leoperezlievano/SDR_UN/HW/shield_SDR_UN/Foto.jpeg

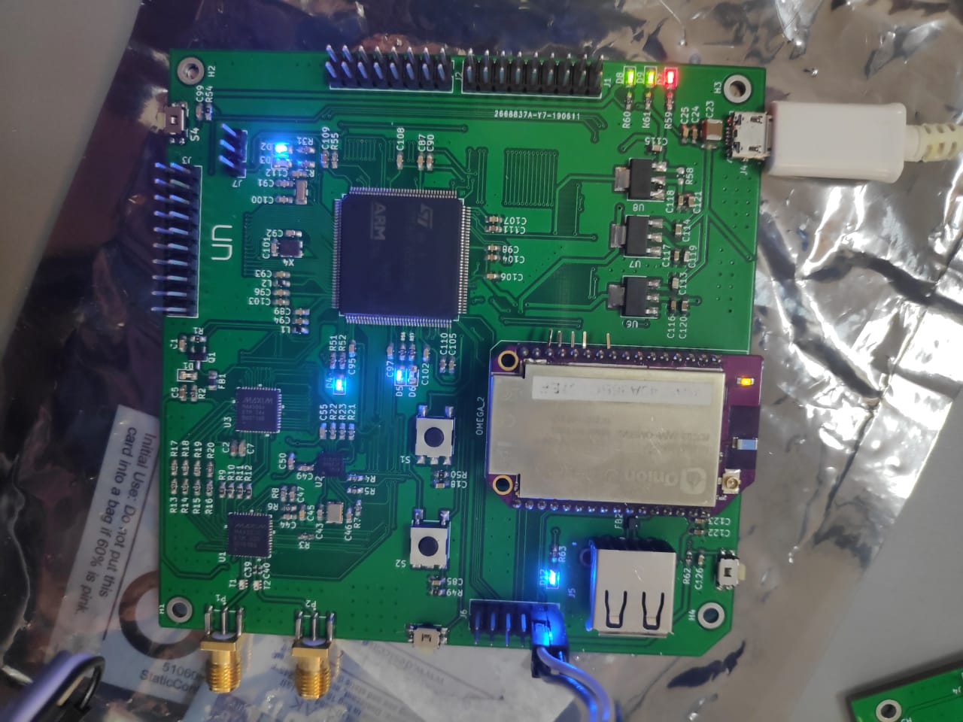
HW/shield_SDR_UN/Foto.jpeg
