leoperezlievano/SDR_UN/Imagenes GITHUB/bot.png

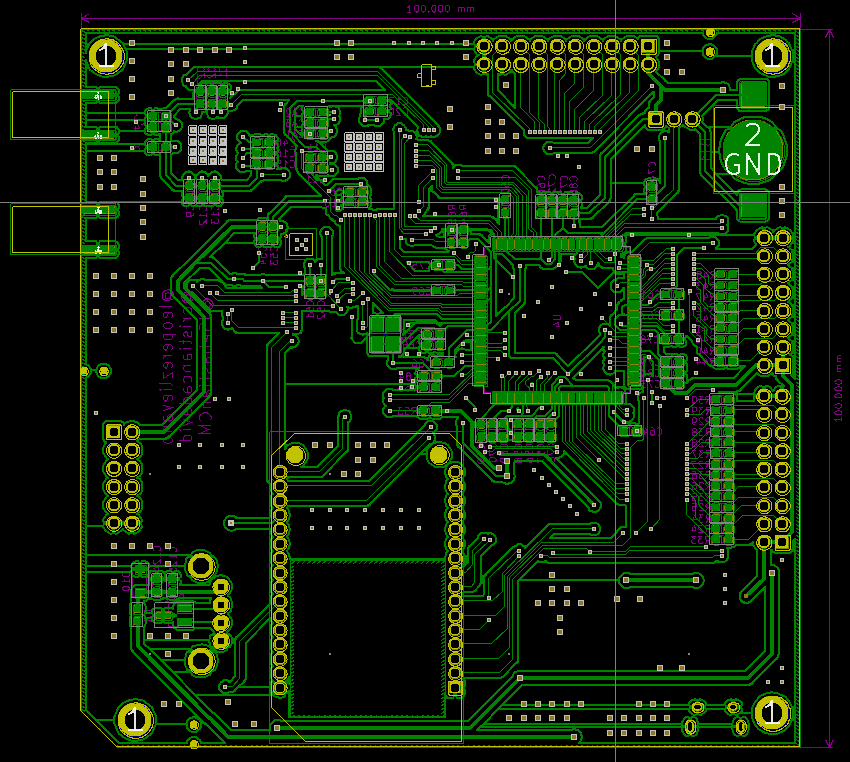
Imagenes GITHUB/bot.png
