leoperezlievano/SDR_UN/Imagenes GITHUB/bot_3d.png

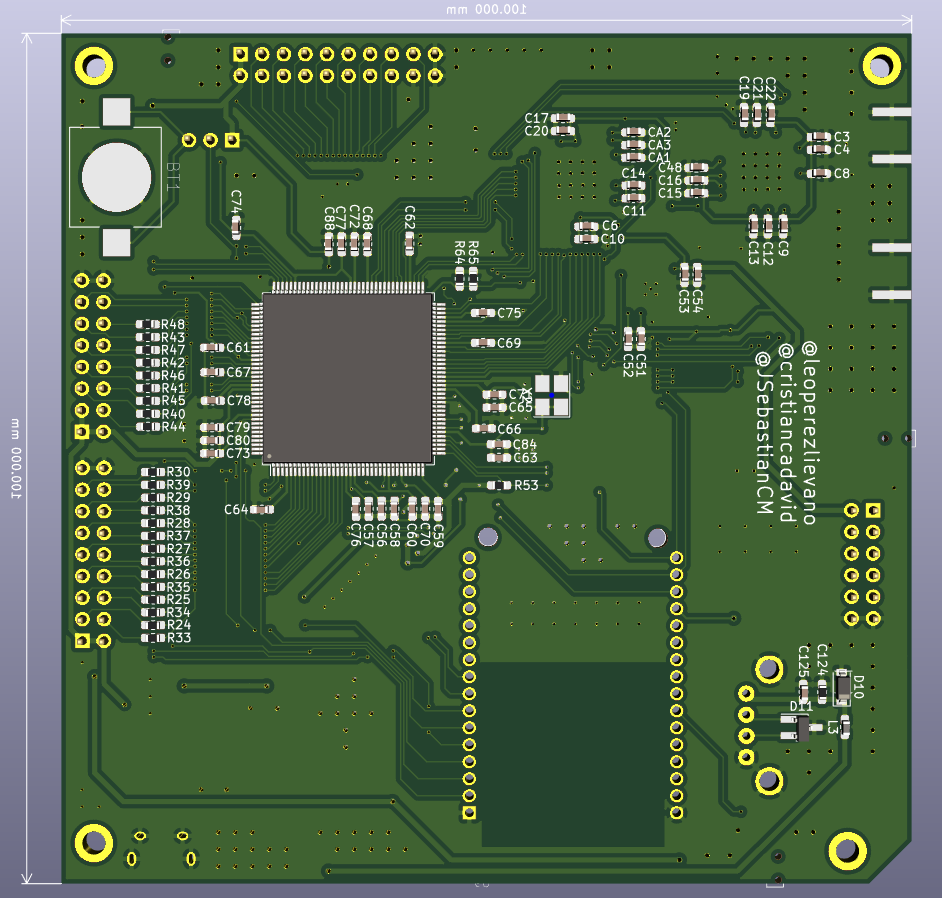
Imagenes GITHUB/bot_3d.png
