leoperezlievano/SDR_UN/Imagenes GITHUB/Esquemático_KiCAD.png

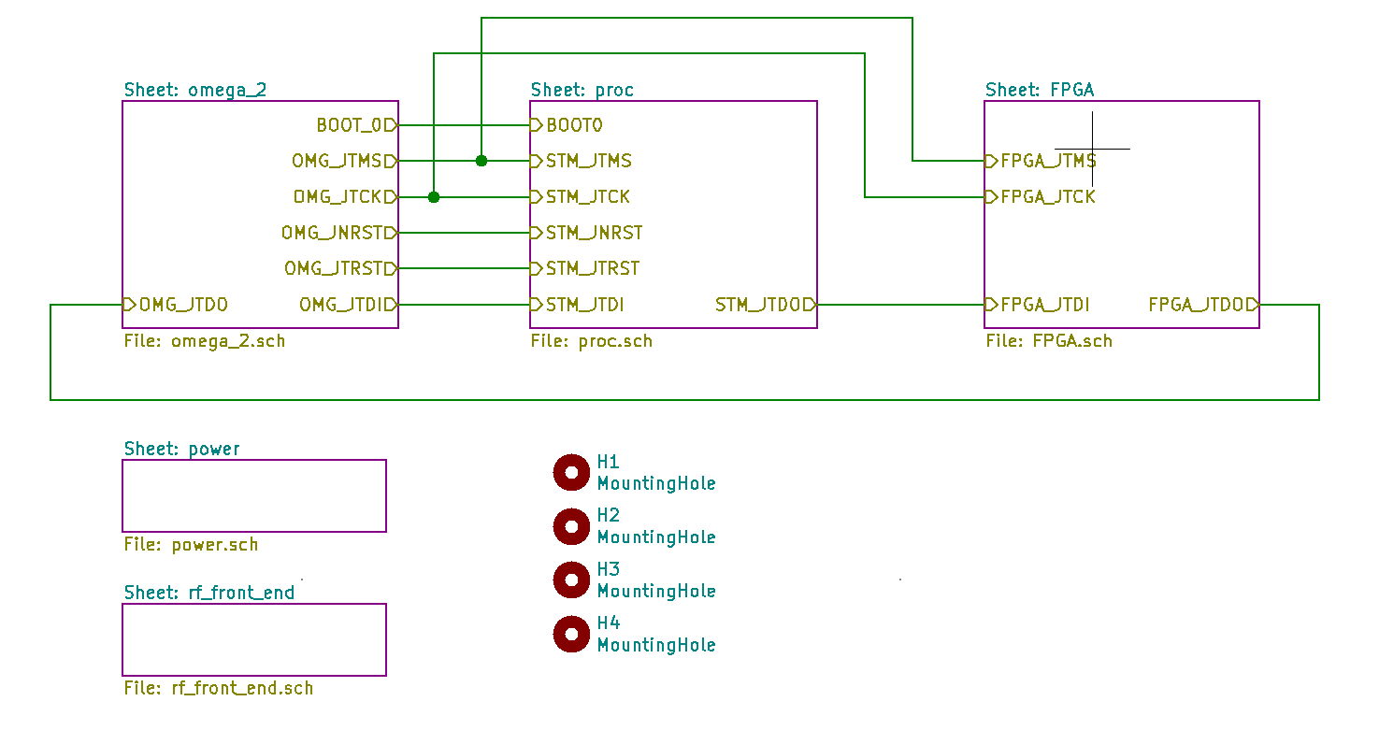
Imagenes GITHUB/Esquemático_KiCAD.png
