leoperezlievano/SDR_UN/Imagenes GITHUB/openocd_1.png

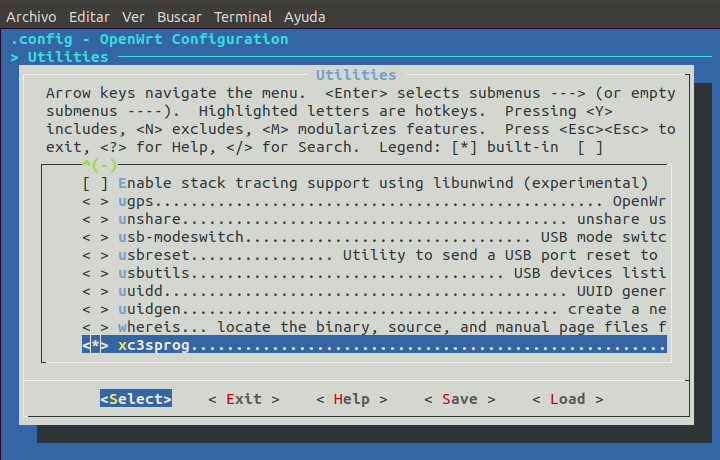
Imagenes GITHUB/openocd_1.png
