leoperezlievano/SDR_UN/Imagenes GITHUB/Roteo.png

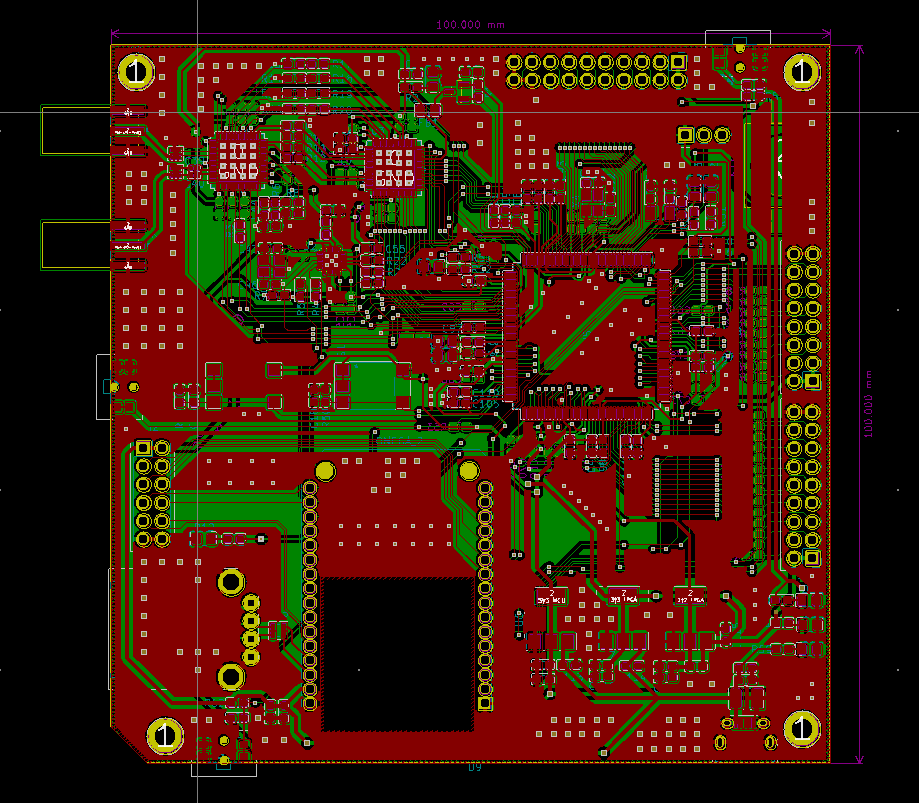
Imagenes GITHUB/Roteo.png
