leoperezlievano/SDR_UN/Imagenes GITHUB/top.png

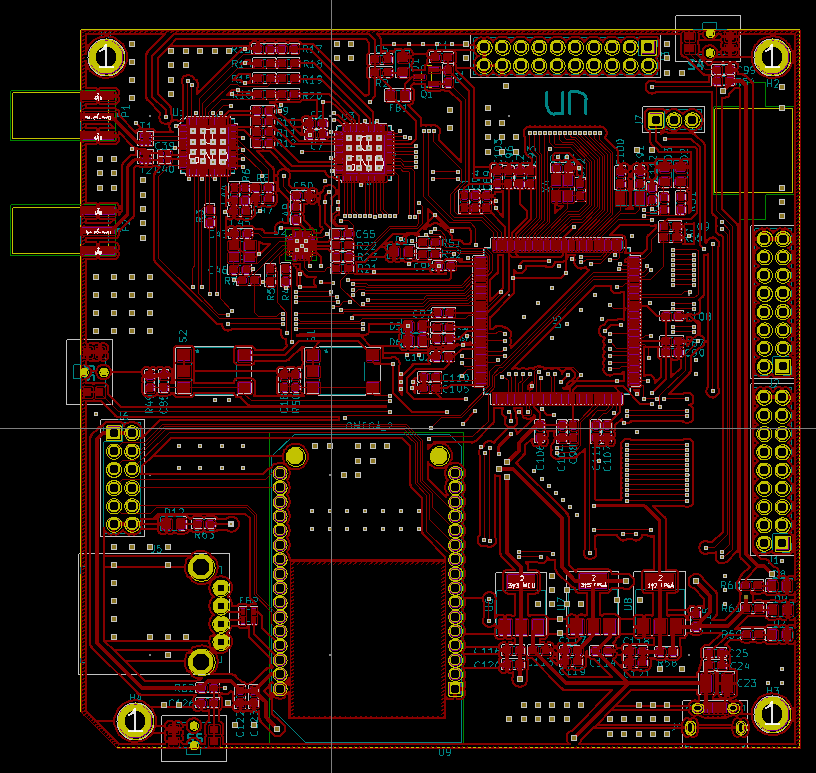
Imagenes GITHUB/top.png
