leoperezlievano/SDR_UN/Imagenes GITHUB/top_3d.png

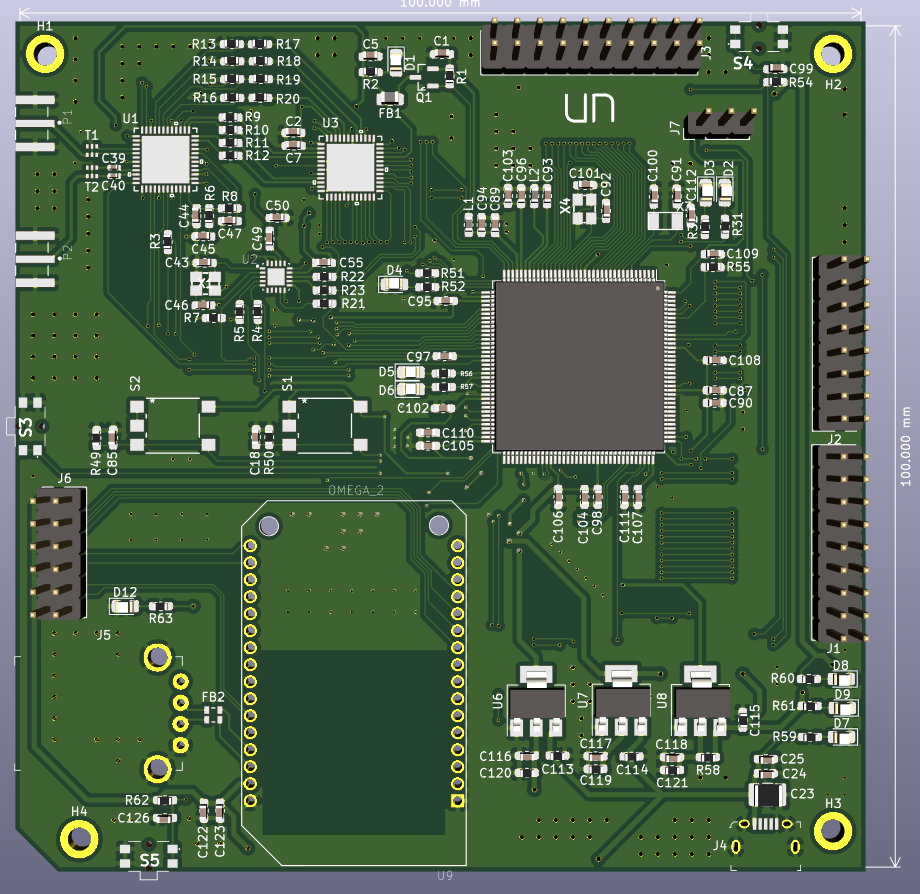
Imagenes GITHUB/top_3d.png
