leoperezlievano/SDR_UN/Imagenes GITHUB/xc3sprog_openocd.png

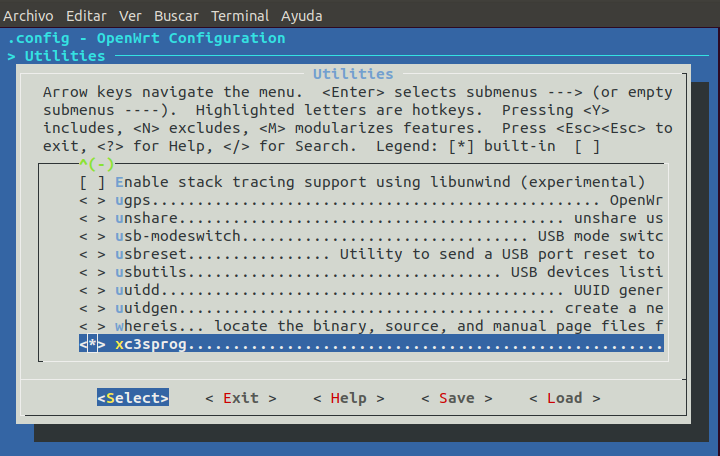
Imagenes GITHUB/xc3sprog_openocd.png
