leoperezlievano/SDR_UN/HW/partes_final.ods

Referencia | Valor | Digikey | Qty (final) | Unit price | Total price
BT1 | Battery_Cell | BK-870-ND | 1 | $0,54 | $0,54
> C3, C8, C9, C12, C22, C44 | 100pF | 1276-1909-1-ND | 10 | $0,04 | $0,42
> C4, C5 | 10uF | 1276-1192-1-ND | 4 | $0,20 | $0,79
> C2, C6, C11, C17, C110, C111 | 2.2uF | 1276-1085-1-ND | 10 | $0,08 | $0,83
> C1, C7, C10, C14, C18, C20, C24, C48, C51-C55, C84, C85, C87-C89, C93, C95-C99, C102, C105-C108, C112, C116-C118, C123, C125, C126 | 100nF | 1276-1000-1-ND | 50 | $0,01 | $0,62
> C13, C15, C16, C19, C21 | 10nF | 1276-1009-1-ND | 10 | $0,04 | $0,39
C23 | 220uF | 1276-3375-1-ND | 2 | $1,68 | $3,36
C25 | 1nF | 1276-1018-1-ND | 2 | $0,10 | $0,20
> C39, C40 | 0 | 311-0.0JRCT-ND | 5 | $0,02 | $0,08
> C43, C46 | 1.8pF | 1276-2218-1-ND | 5 | $0,05 | $0,24
C45 | 2.2nF | 1276-1987-1-ND | 2 | $0,10 | $0,20
C47 | 68pF | 1276-6538-1-ND | 2 | $0,10 | $0,20
C49 | 33pF | 1276-1070-1-ND | 2 | $0,10 | $0,20
C50 | 47pF | 1276-1037-1-ND | 2 | $0,10 | $0,20
> C56-C66, C71, C72, C77, C79, C109 | 4.7uF | 1276-1045-1-ND | 20 | $0,04 | $0,78
> C67-C70, C73-C76, C78, C80 | 0.47uF | 1276-2082-1-ND | 15 | $0,07 | $1,10
> C91, C100 | 6pF | 1276-2133-1-ND | 5 | $0,04 | $0,21
> C92, C101 | 10pF | 1276-1027-1-ND | 5 | $0,04 | $0,20
> C90, C94, C103, C104, C122 | 1uF | 1276-1182-1-ND | 10 | $0,04 | $0,38
> C113-C115, C119-C121, C124 | 22uF | 1276-6504-1-ND | 10 | $0,24 | $2,38
> CA1-CA3 | 330nF | 1276-2048-1-ND | 5 | $0,09 | $0,46
> D1, D8, D9 | LED_GREEN | 160-1468-1-ND | 5 | $0,29 | $1,45
> D2-D6, D12 | LED_BLUE | 160-2032-1-ND | 10 | $0,36 | $3,60
D7 | LED_RED | 160-1469-1-ND | 2 | $0,31 | $0,62
D10 | D_Zener-5.1V-1W | MMSZ5231BT1GOSCT-ND | 2 | $0,23 | $0,46
D11 | SP0502BAHT | F2714CT-ND | 2 | $0,73 | $1,46
FB1 | FILTER | 490-1054-1-ND | 2 | $0,10 | $0,20
FB2 | SRF2012-900YA | SRF2012-900YACT-ND | 1 | $0,36 | $0,36
J1 | Conn_02x09_Odd_Even | 609-6336-ND | 1 | $0,89 | $0,89
J2 | Conn_02x08_Odd_Even | 609-6336-ND | 1 | $0,89 | $0,89
J3 | Conn_02x10_Top_Bottom | 609-3221-ND | 1 | $0,72 | $0,72
J4 | USB_B_Micro | 609-4618-1-ND | 2 | $0,42 | $0,84
J5 | USB_A | UE27AC54100-ND | 1 | $0,60 | $0,60
J6 | Conn_02x06_Odd_Even | 609-3219-ND | 1 | $0,44 | $0,44
J7 | Conn_01x03_Male | 732-5316-ND | 1 | $0,13 | $0,13
> L1, L2 | bead, 600R, 350 mA | 587-1897-1-ND | 2 | $0,10 | $0,20
L3 | L | 732-1593-1-ND | 2 | $0,17 | $0,34
> P1, P2 | GSG-RF-CONN | CON-SMA-EDGE-S-ND | 2 | $1,74 | $3,48
Q1 | MOSFET_P | DMP2305UDICT-ND | 2 | $0,51 | $1,02
> R1, R49, R50, R54, R62 | 10k | 311-10KGRCT-ND | 10 | $0,02 | $0,20
> R2, R31, R32, R51, R52, R56, R57, R60, R61, R63 | 470 | 311-470GRCT-ND | 15 | $0,02 | $0,30
> R4, R5, R7, R59 | 1.8k | 311-1.8KGRCT-ND | 10 | $0,02 | $0,20
R6 | 1.2k | 311-1.20KHRCT-ND | 2 | $0,10 | $0,20
R8 | 750 | 311-750HRCT-ND | 2 | $0,10 | $0,20
> R9-R12 | 0 | RMCF0603ZT0R00CT-ND | 10 | $0,02 | $0,16
> R13-R16, R53 | 4.7k | 311-4.70KHRCT-ND | 10 | $0,02 | $0,24
> R3, R17-R20, R55 | 1k | 311-1.00KHRCT-ND | 10 | $0,02 | $0,24
 | 39 | 311-39.0HRCT-ND | 10 | $0,02 | $0,24
> R24-R30, R33-R48 | 200 | 311-200GRCT-ND | 30 | $0,02 | $0,60
R58 | 100 | 311-100HRCT-ND | 2 | $0,10 | $0,20
> R64, R65 | 1.5k | 311-1.5KGRCT-ND | 4 | $0,10 | $0,40
> S1, S2 | FSM1LPTR | 450-1756-1-ND | 3 | $0,48 | $1,44
> S3-S5 | TL1014BF160QG | EG5042CT-ND | 5 | $0,81 | $4,05
> T1, T2 | BALUN | 445-172632-1-ND | 3 | $0,35 | $1,05
U1 | MAX2830 | MAX2830ETM+TCT-ND | 1 | $10,65 | $10,65
U2 | SI5351C | 336-5160-1-ND | 1 | $2,42 | $2,42
U3 | MAX5864 | MAX5864ETM+-ND | 1 | $11,21 | $11,21
U4 | XC6SLX9-2TQG144C | 122-1745-ND | 1 | $16,52 | $16,52
U5 | STM32F722ZET | 497-18558-ND | 1 | $10,74 | $10,74
> U6, U7 | ZLDO1117G33TA | ZLDO1117G33DICT-ND | 4 | $0,50 | $2,00
U8 | ZLDO1117G12TA | ZLDO1117G12DICT-ND | 3 | $0,50 | $1,50
X1 | GSG-XTAL4PIN-25MHz | 535-13468-1-ND | 1 | $0,74 | $0,74
X2 | ASE-xxxMHz | 535-11114-1-ND | 1 | $3,30 | $3,30
X3 | CRYSTAL | 644-1171-1-ND | 1 | $0,68 | $0,68
X4 | GSG-XTAL4PIN-16MHz | 535-10289-1-ND | 1 | $0,73 | $0,73
Extra Capacitors 1 | 3pF | 1276-1597-1-ND | 3 | $0,10 | $0,30
Extra Capacitors 2 | 22pF | 1276-6456-1-ND | 3 | $0,14 | $0,42
Terminal Strip Onion | Conn_01x16 | 1212-1317-ND | 1 | $3,32 | $3,32
SMA Extra | SMA | WM5536-ND | 1 | $3,64 | $3,64
 |  |  |  | TOTAL | $109,36 | USD
 |  |  |  | TRM | $3.288,00
 |  |  |  |  | $359.565,82 | COP
