leoperezlievano/SDR_UN/(threads)

Thread 1 (2019-07-24):

Wiki

cristiancadavid, 2019-07-24:
Bienvenidos
Bienvenido a su SDR_UN wiki, donde econtrará los pasos necesarios para diseñar y poner en funcionamiento una PCB que cuenta con un sistema embebido Onion-Omega2, un microcontrolador STM32F7422 y finalmente una FPGA x9
