leoperezlievano/SDR_UN/HW/shield_SDR_UN/shield_SDR_UN.pdf

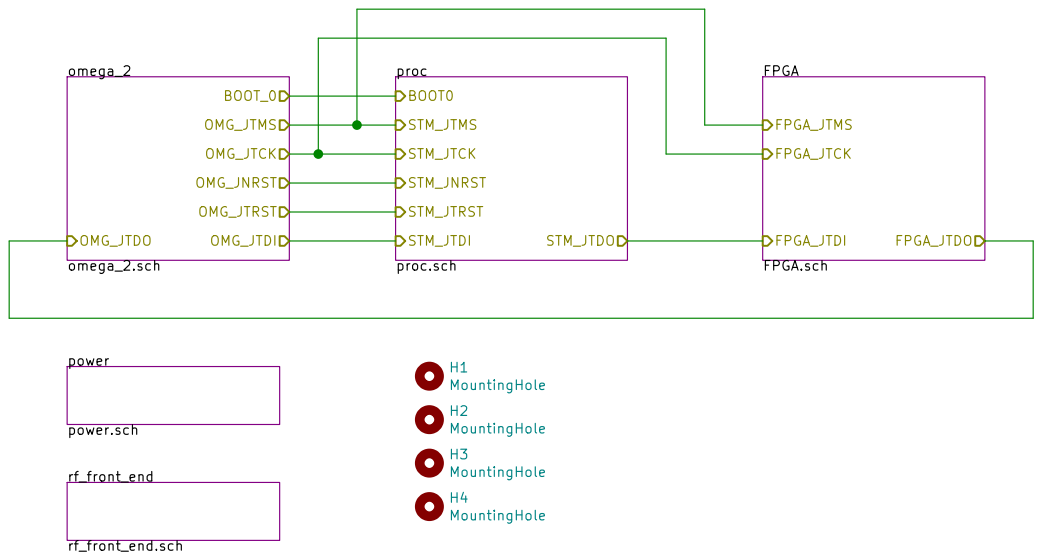
[picture p10: page 1]

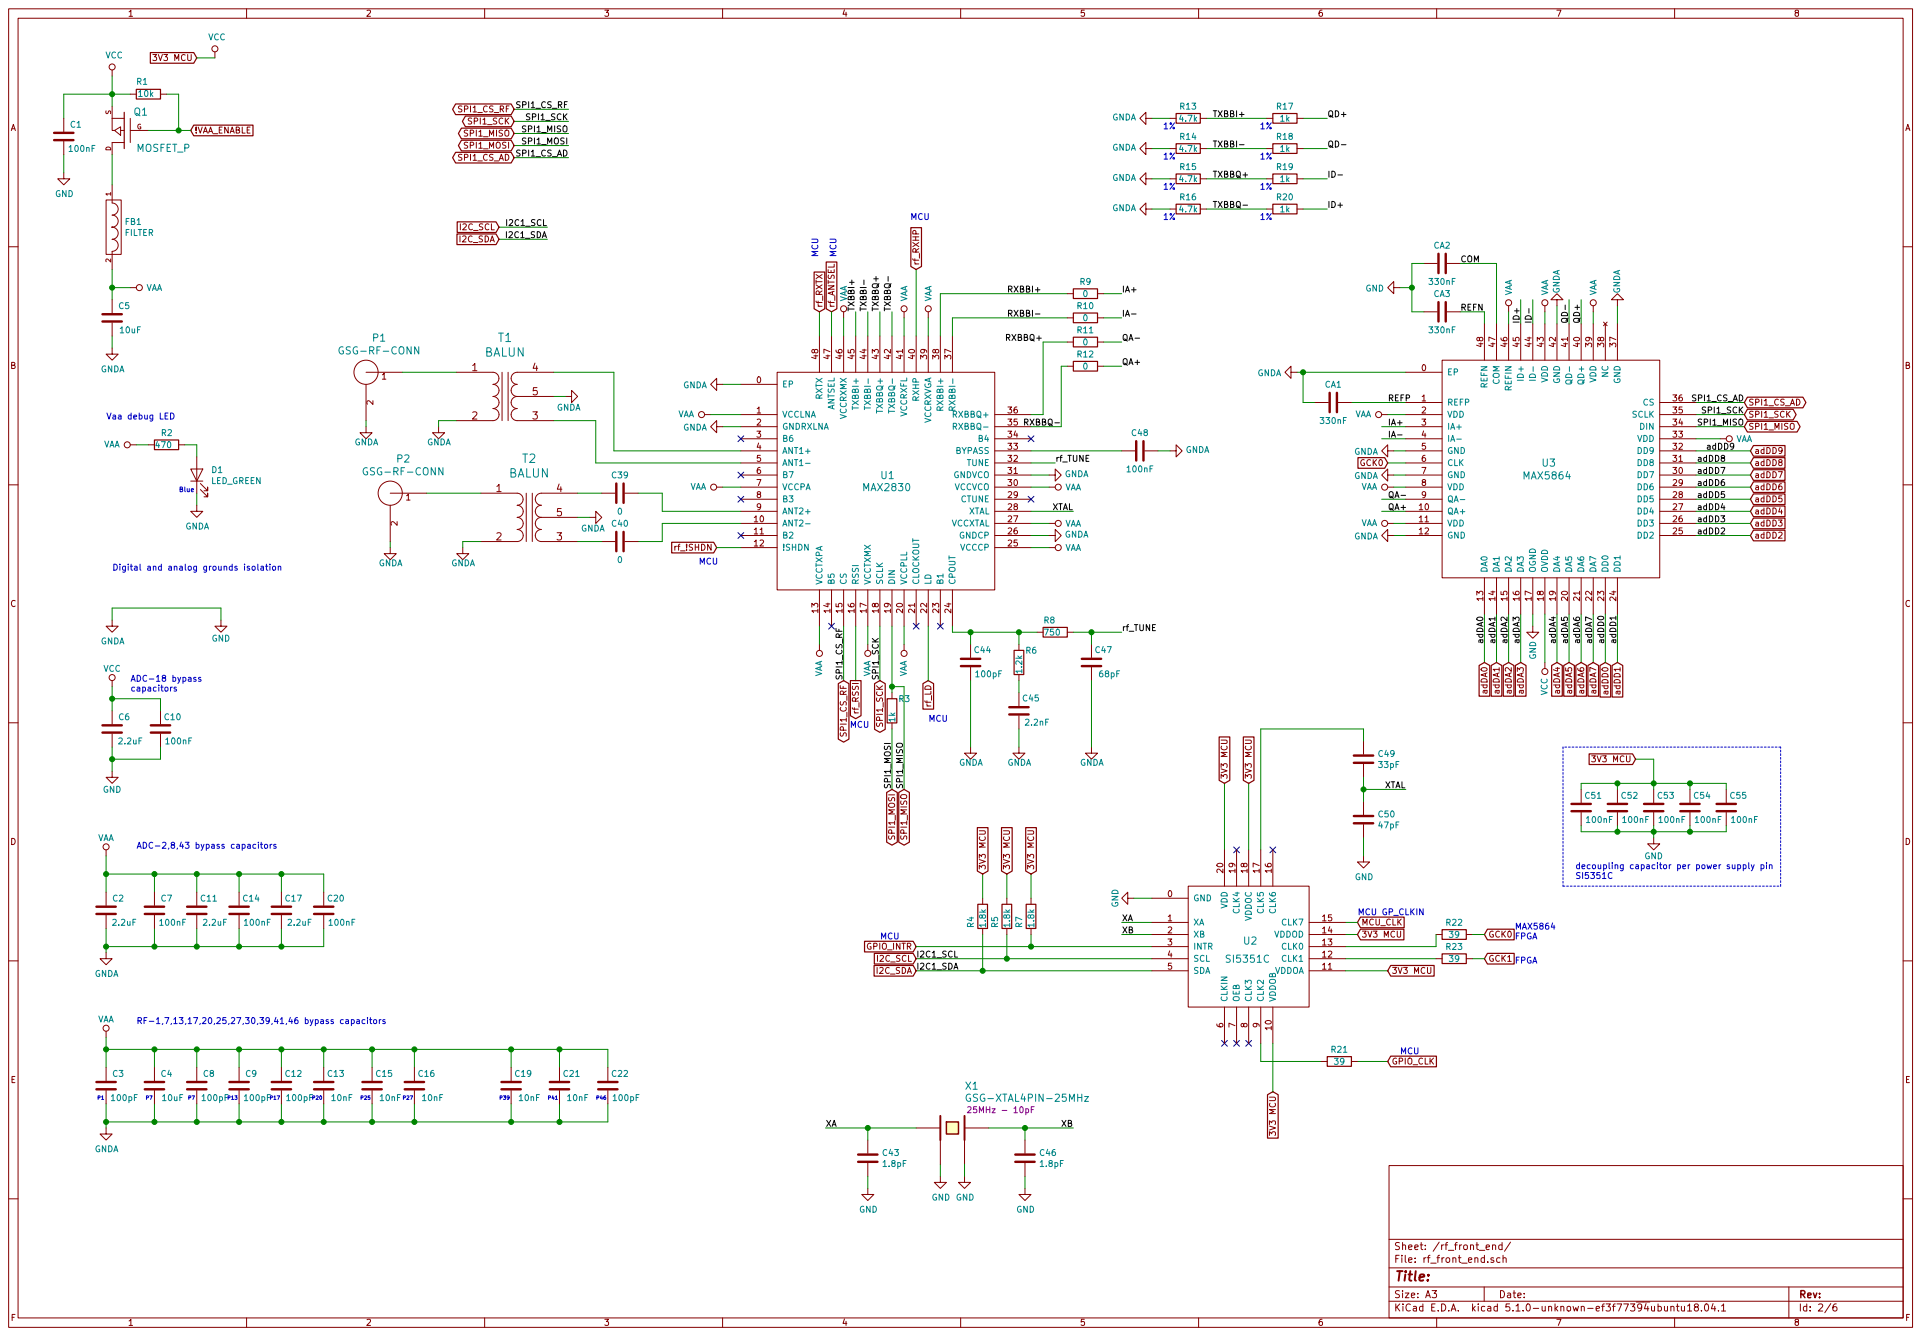
[picture p11: page 2]

GNDA GNDA

IA- QA- QA+ RXBBQ- RXBBQ+ RXBBI- RXBBI+ 1

decoupling capacitor per power supply pin SI5351C

FPGA MAX5864 FPGA MCU_CLK MCU GP_CLKIN GND GND

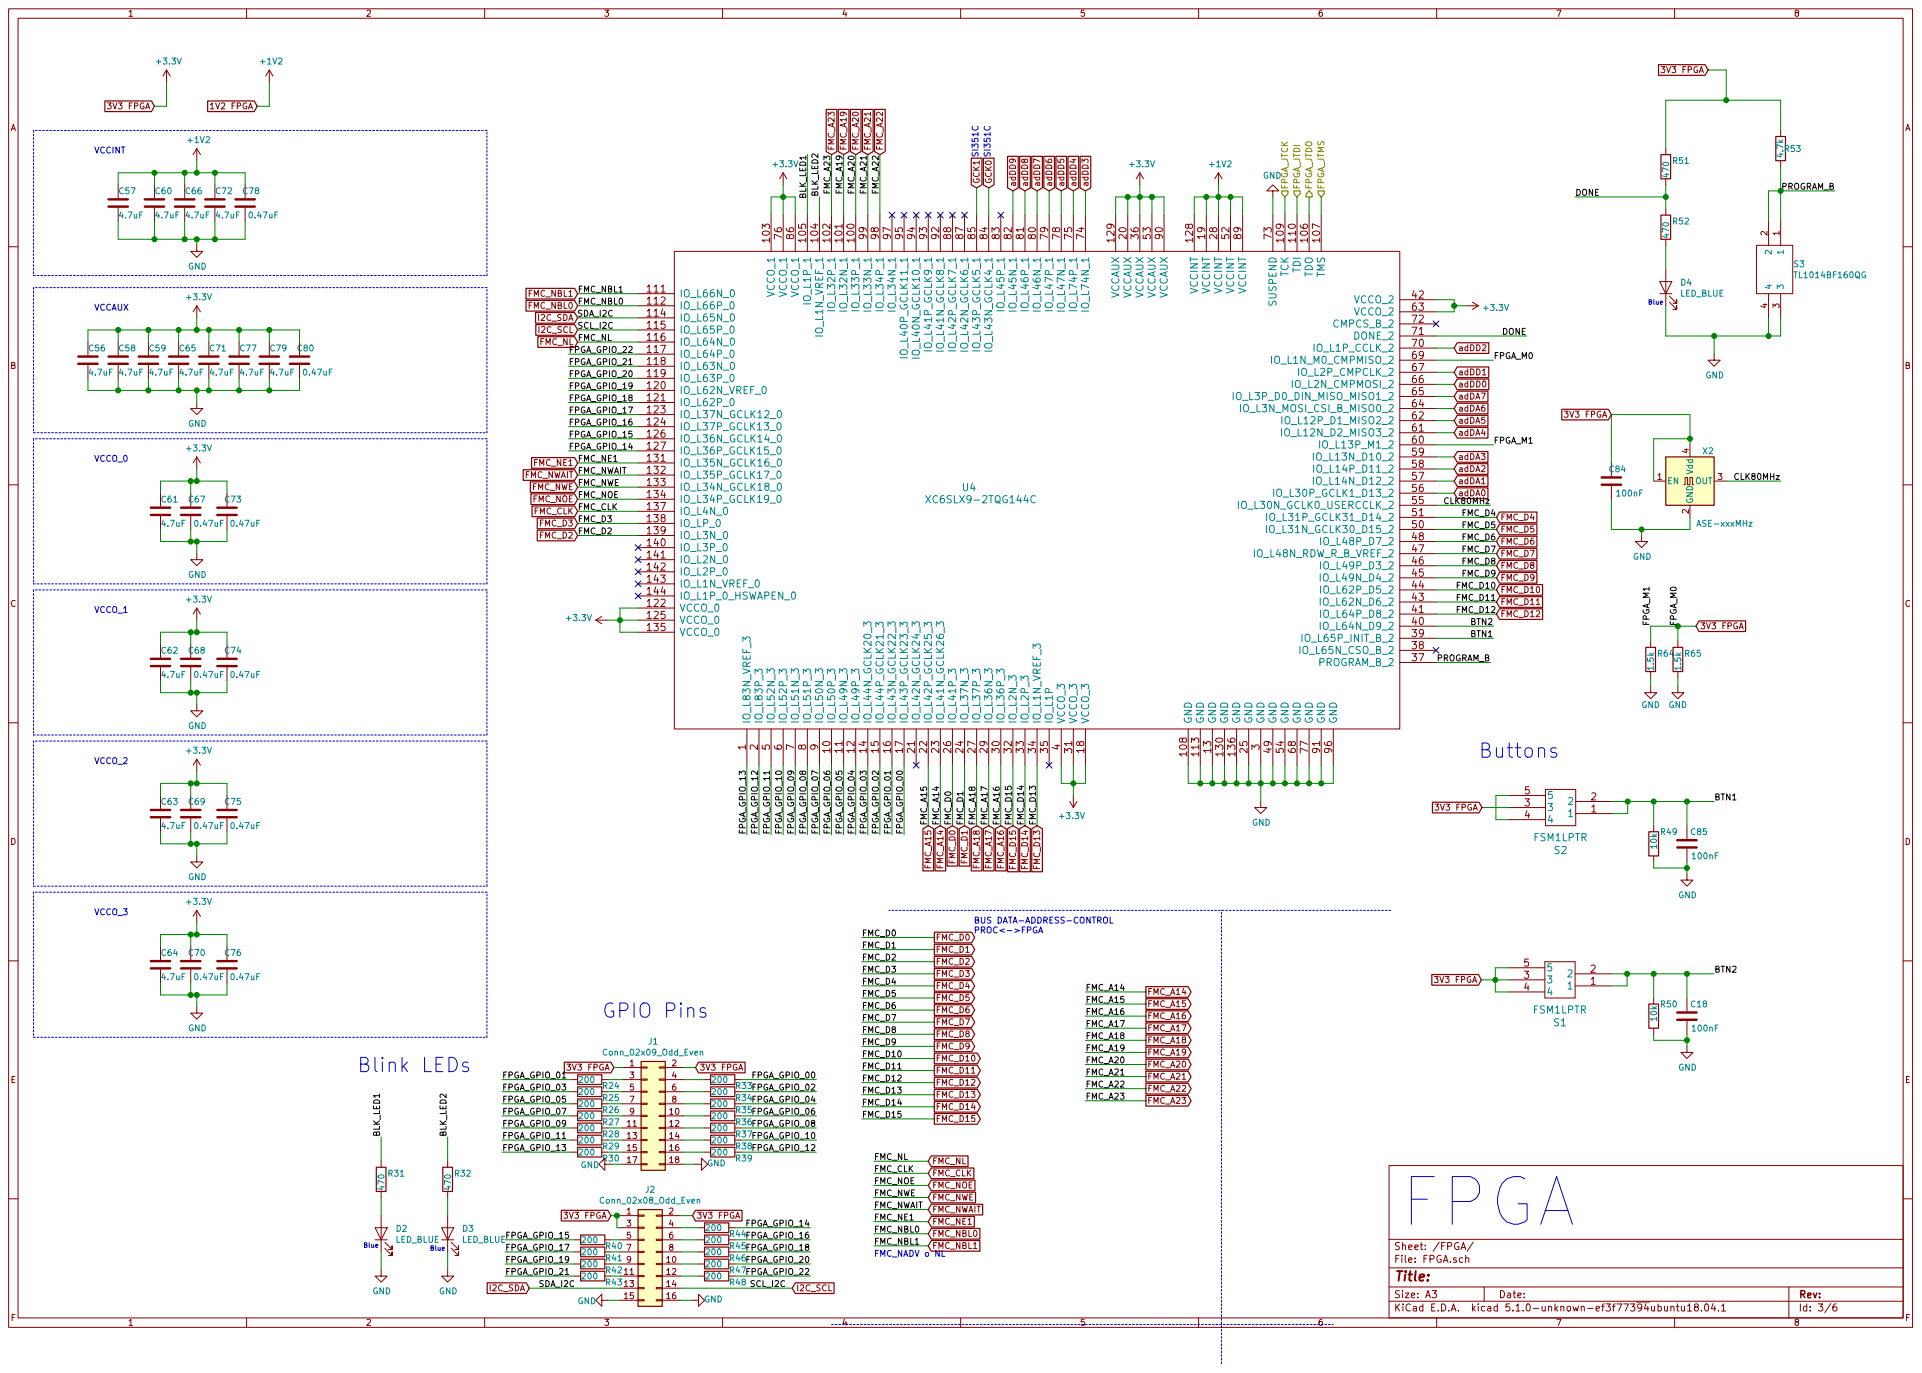
[picture p12: page 3]

4X2 ASE-xxxMHz 3V3 FPGA GND

Id: 3/6 Title: File: FPGA.sch Sheet: /FPGA/ IO_L83N_VREF_3

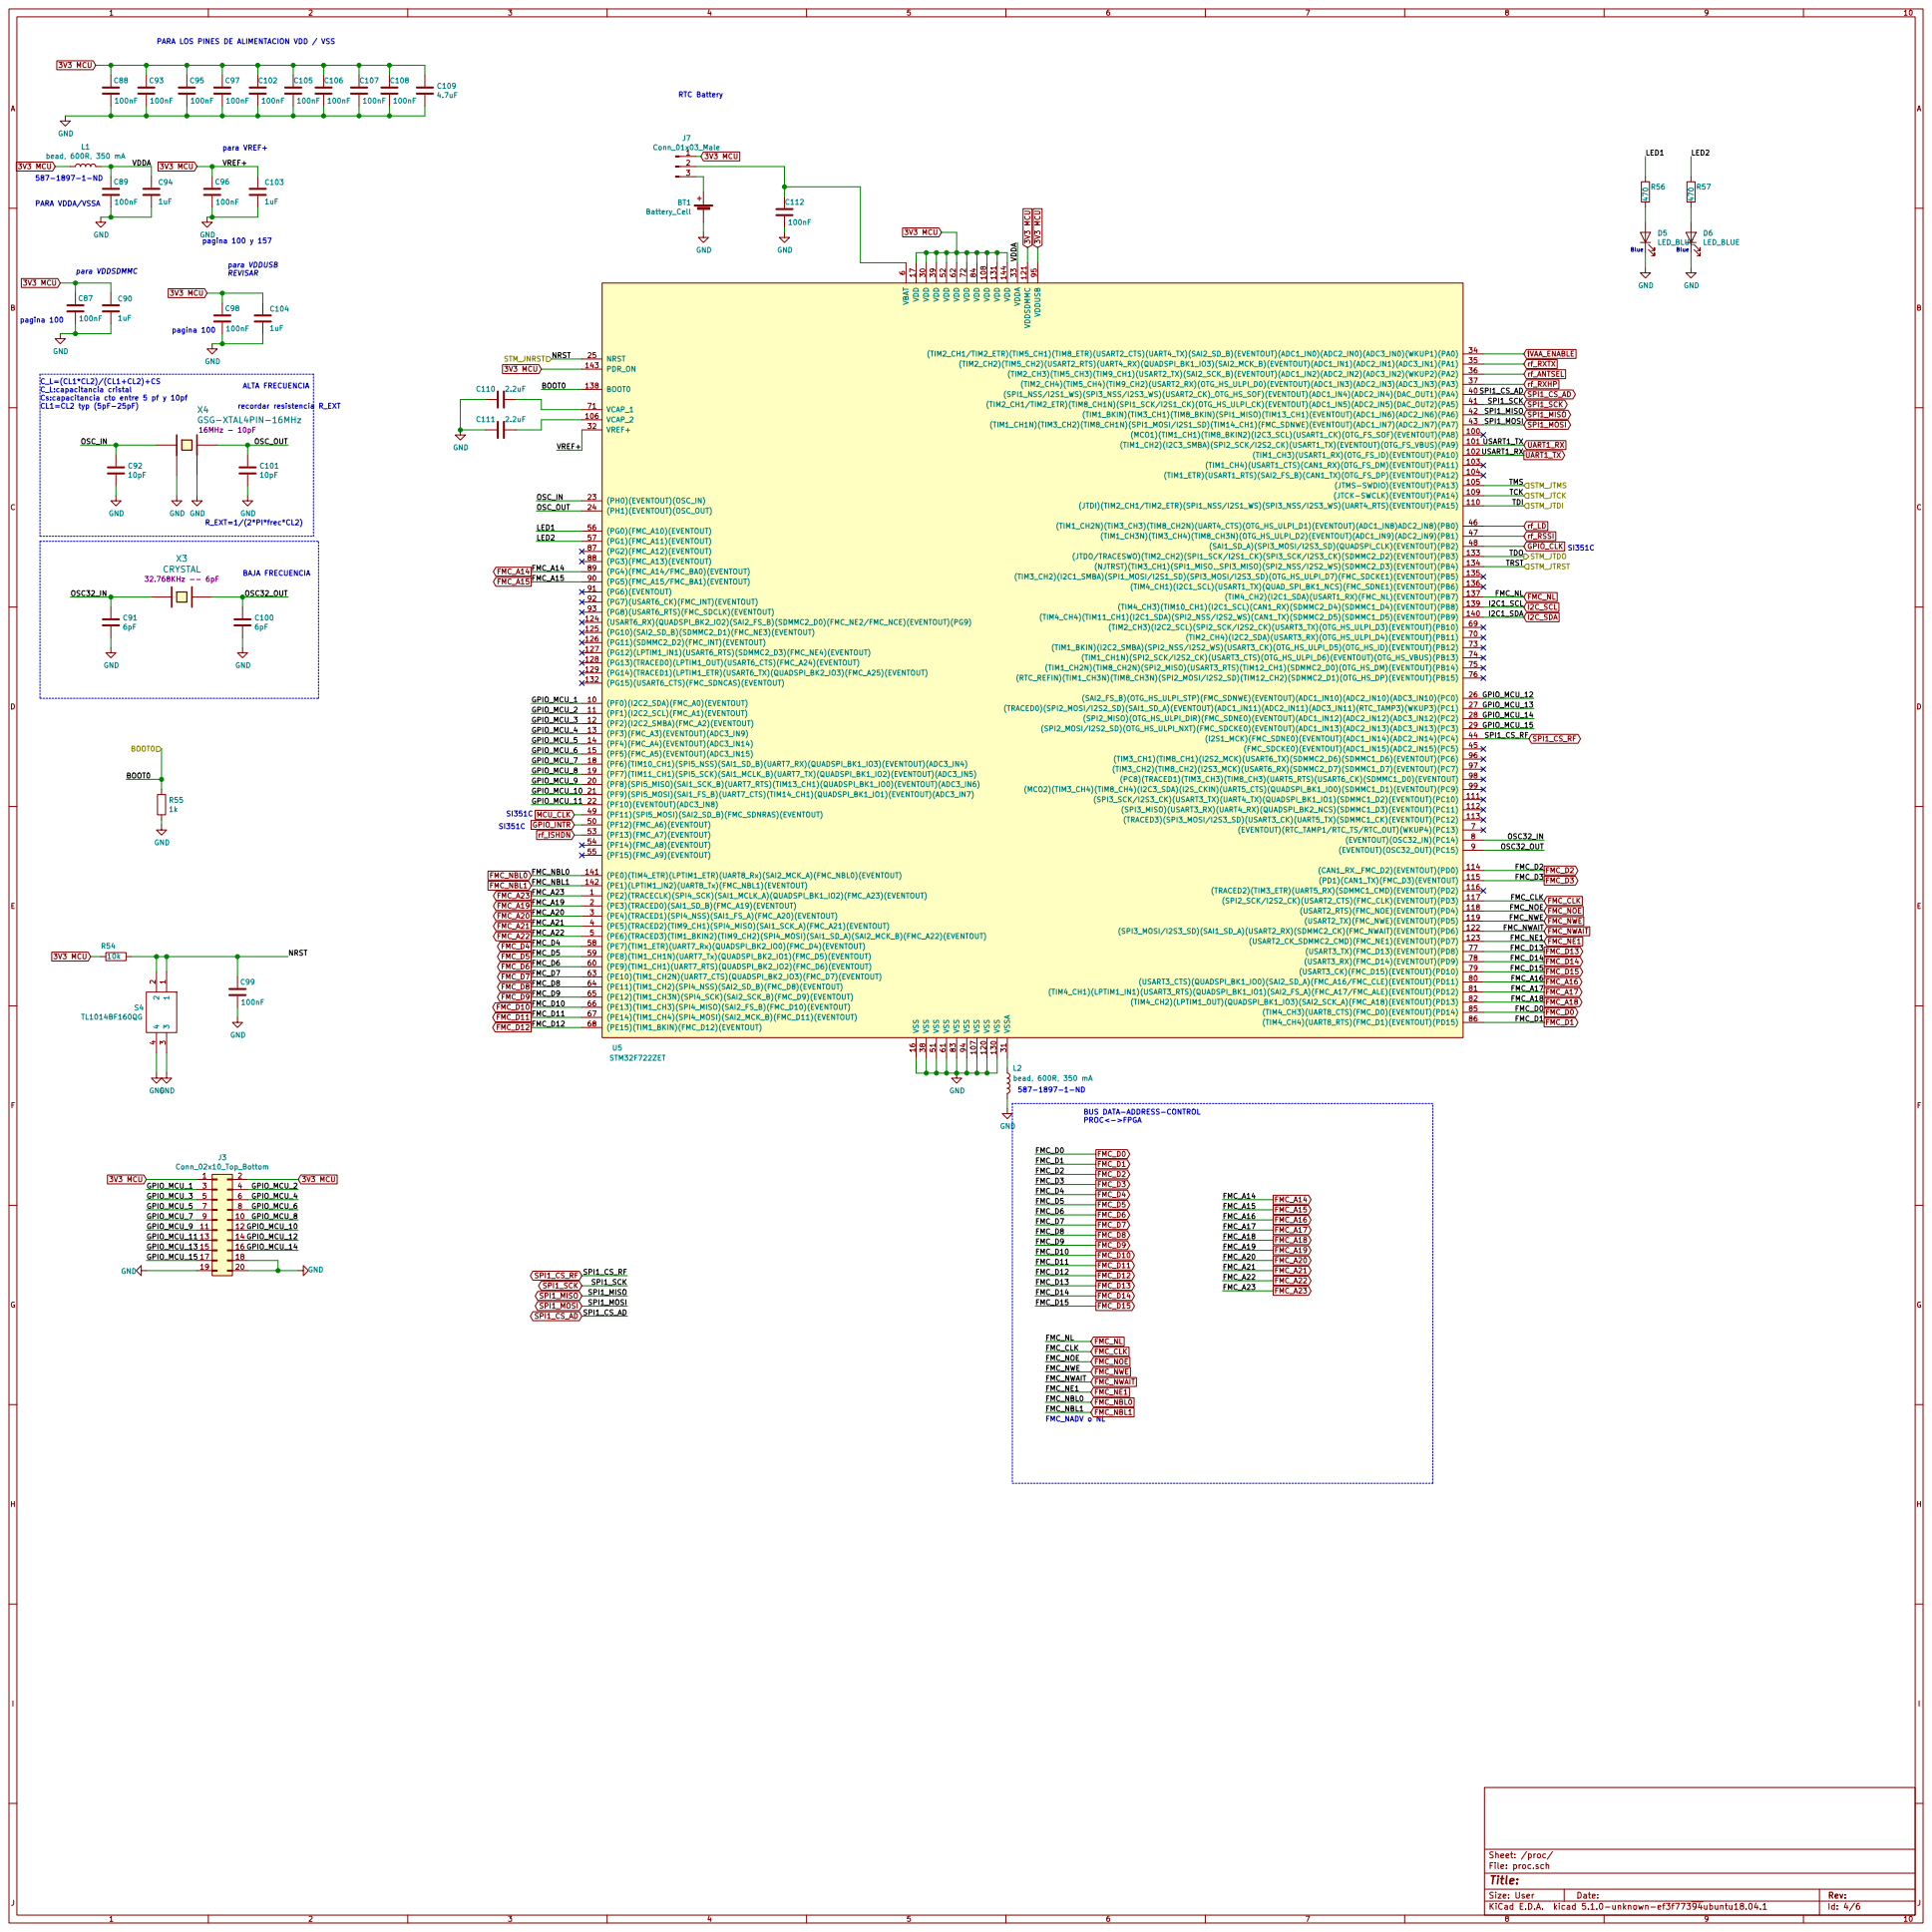
[picture p13: page 4]

PARA LOS PINES DE ALIMENTACION VDD / VSS

C_L:capacitancia cristal
Cs:capacitancia cto entre 5 pf y 10pf

BUS DATA-ADDRESS-CONTROL PROC<->FPGA

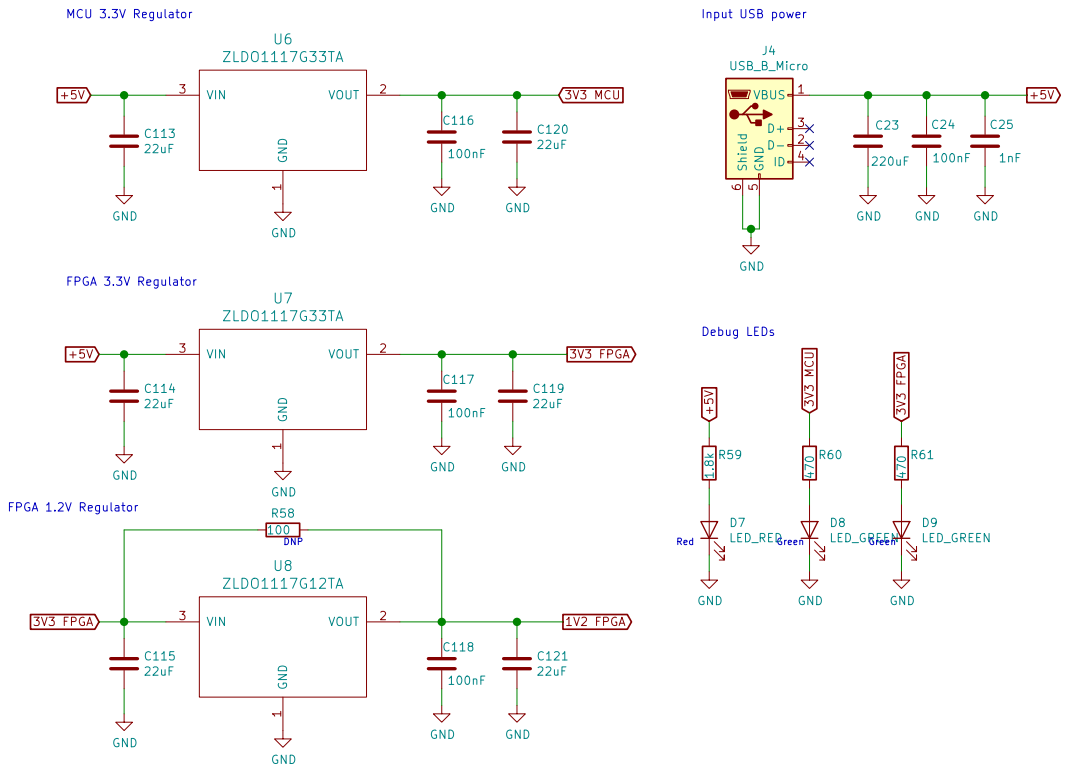
[picture p14: page 5]

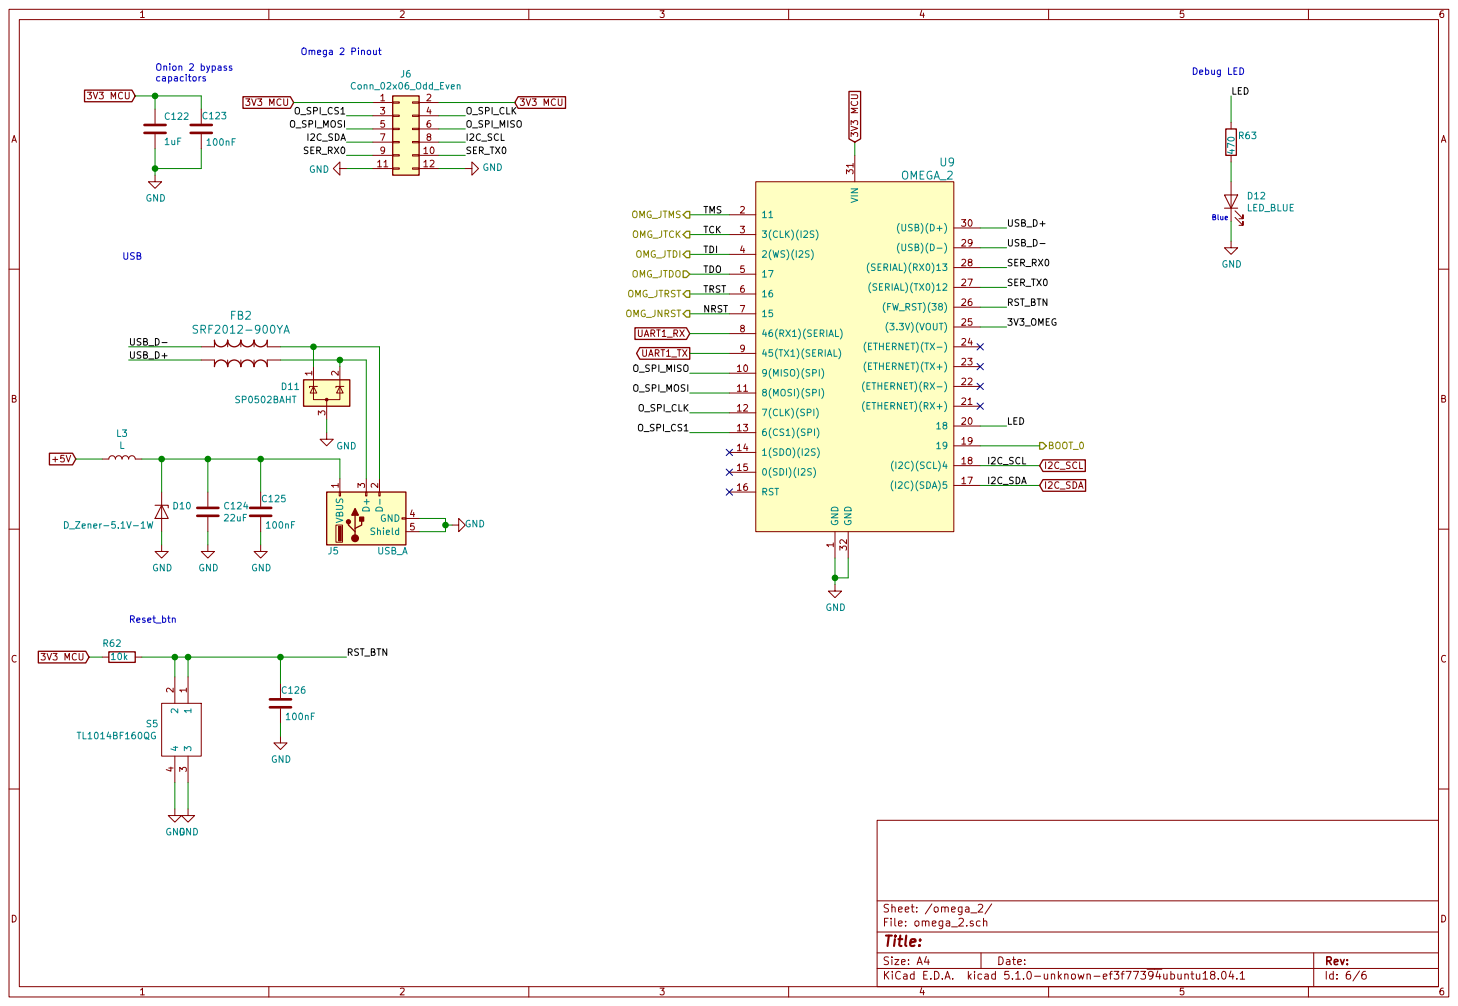
[picture p15: page 6]
