leoperezlievano/SDR_UN/HW/shield_SDR_UN/gerbers/shield_SDR_UN-B_Cu.pdf

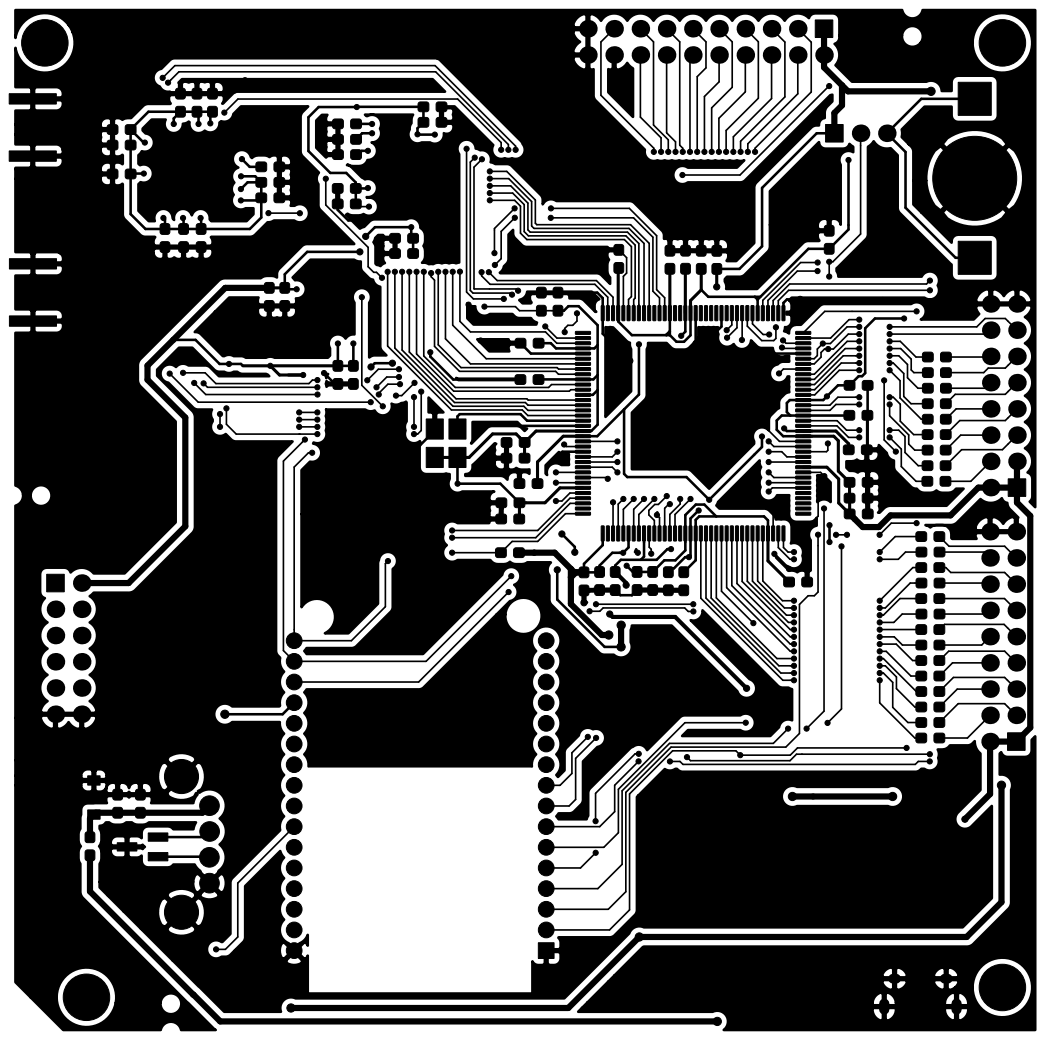
[picture p22: page 1]
