leoperezlievano/SDR_UN/HW/shield_SDR_UN/gerbers/shield_SDR_UN-B_Mask.pdf

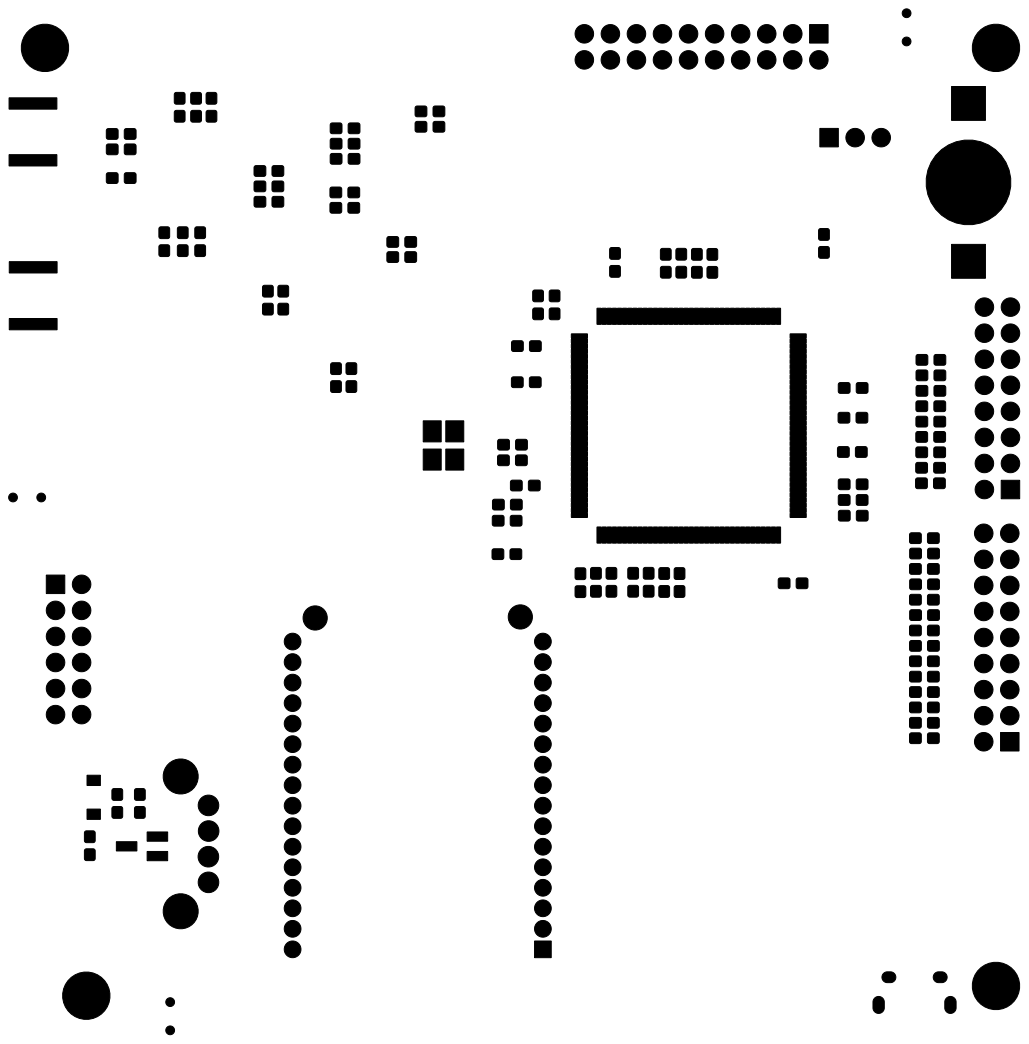
[picture p23: page 1]
