leoperezlievano/SDR_UN/HW/shield_SDR_UN/gerbers/shield_SDR_UN-B_Paste.pdf

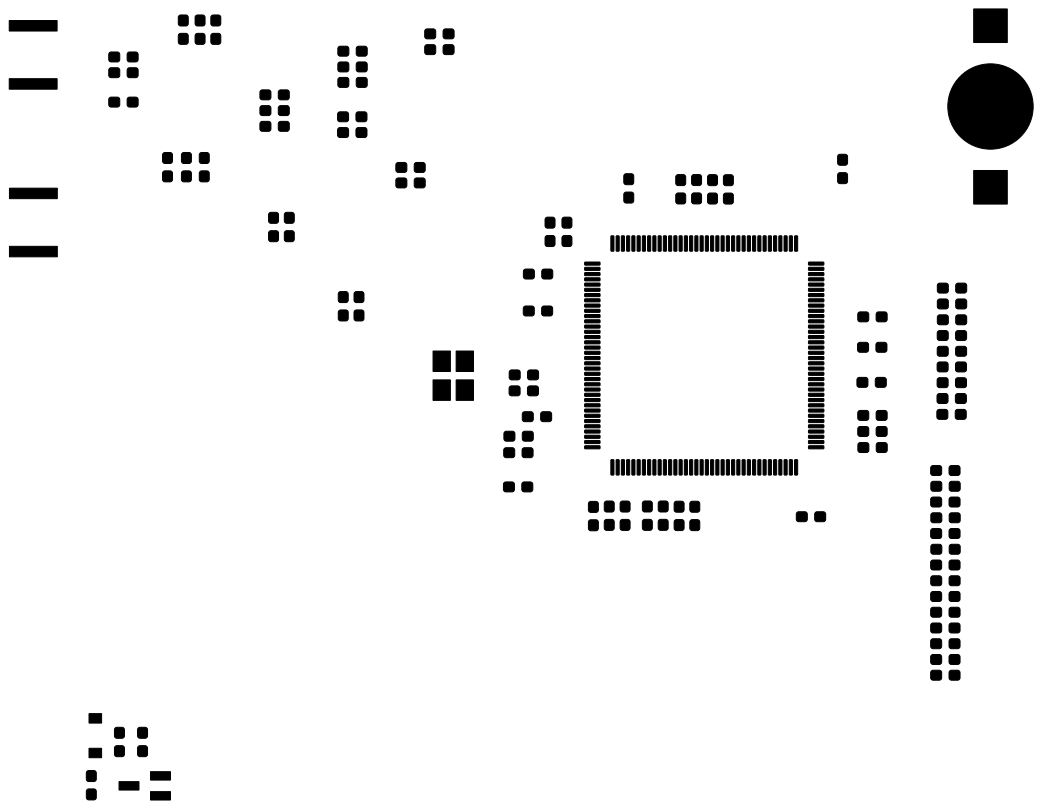
[picture p24: page 1]
