leoperezlievano/SDR_UN/HW/shield_SDR_UN/gerbers/shield_SDR_UN-B_SilkS.pdf

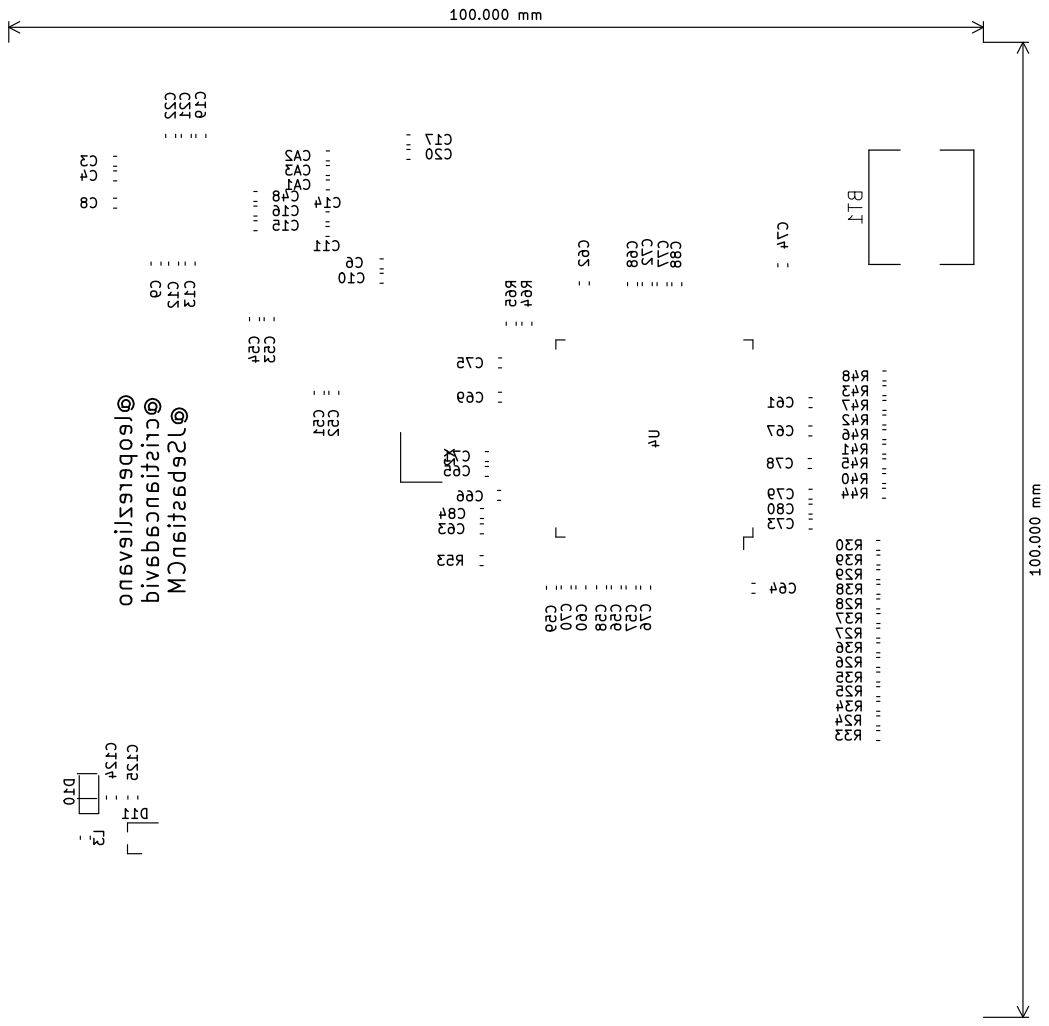
[picture p25: page 1]
