leoperezlievano/SDR_UN/HW/shield_SDR_UN/gerbers/shield_SDR_UN-F_Cu.pdf

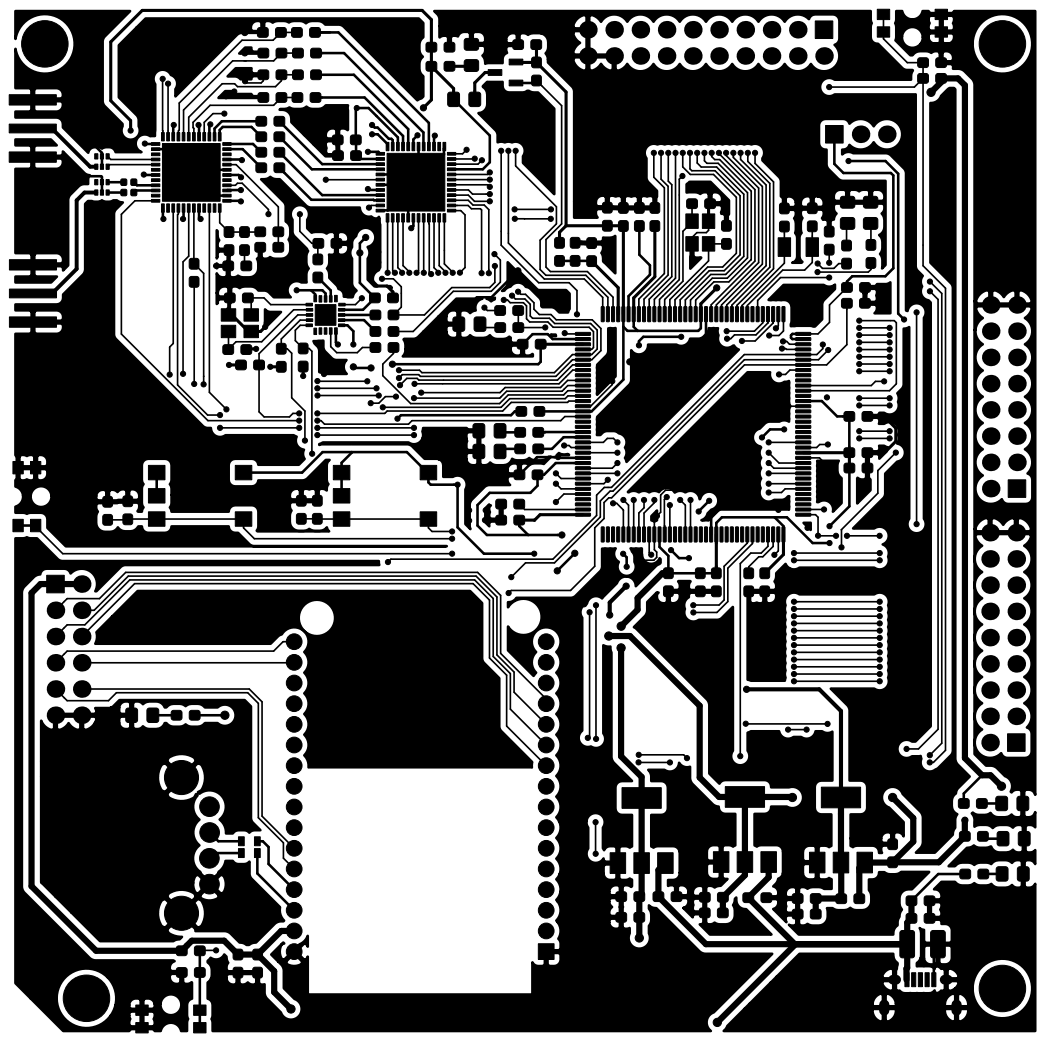
[picture p26: page 1]
