leoperezlievano/SDR_UN/HW/shield_SDR_UN/gerbers/shield_SDR_UN-F_Mask.pdf

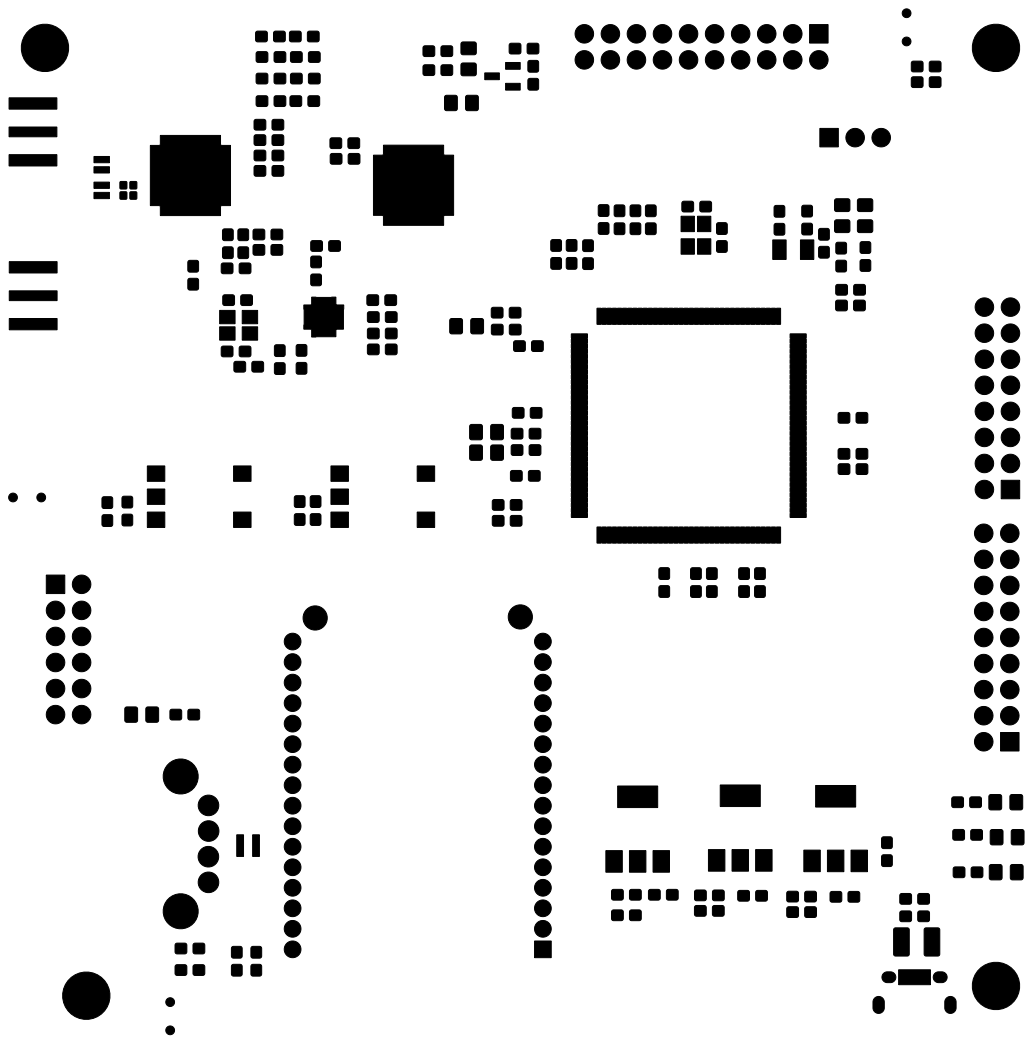
[picture p27: page 1]
