leoperezlievano/SDR_UN/HW/shield_SDR_UN/gerbers/shield_SDR_UN-F_Paste.pdf

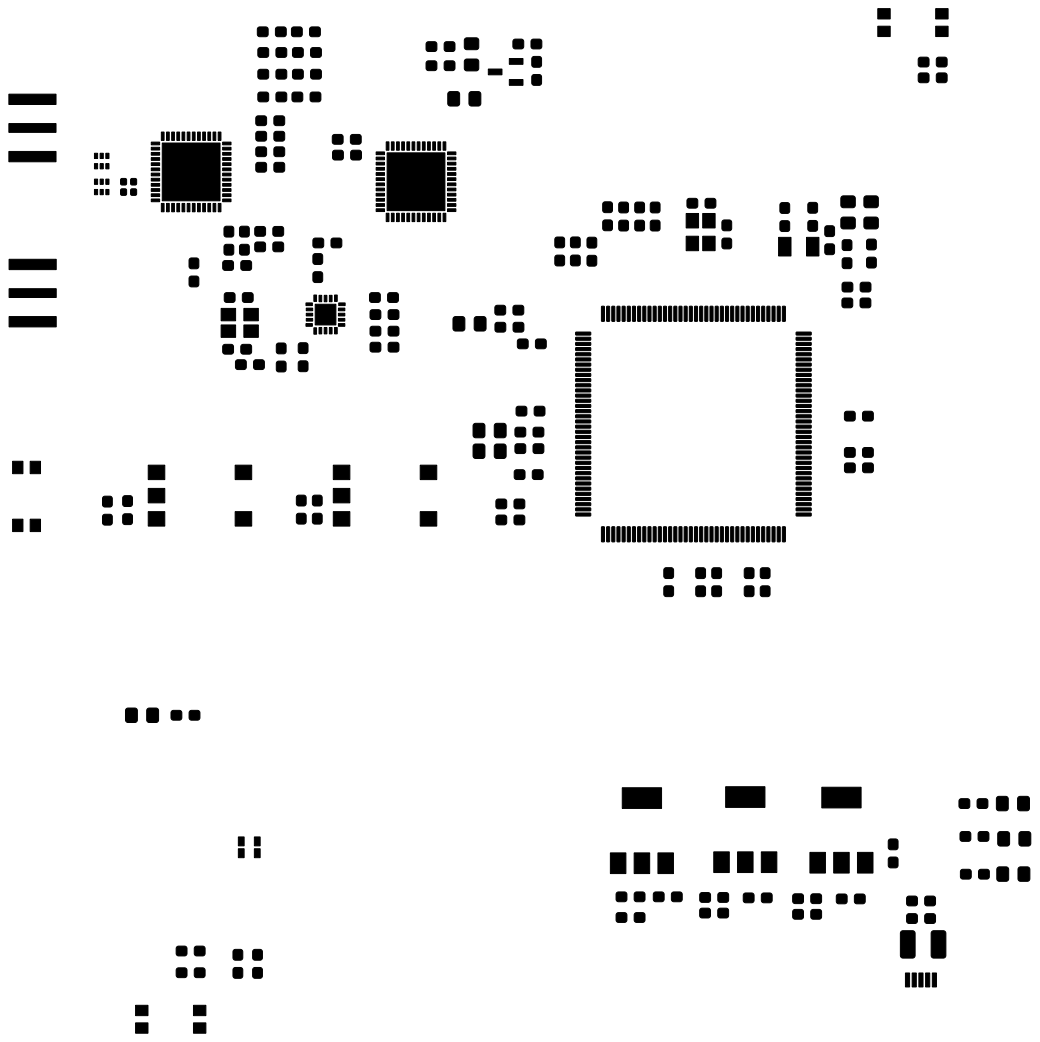
[picture p28: page 1]
