leoperezlievano/SDR_UN/HW/shield_SDR_UN/gerbers/shield_SDR_UN-F_SilkS.pdf

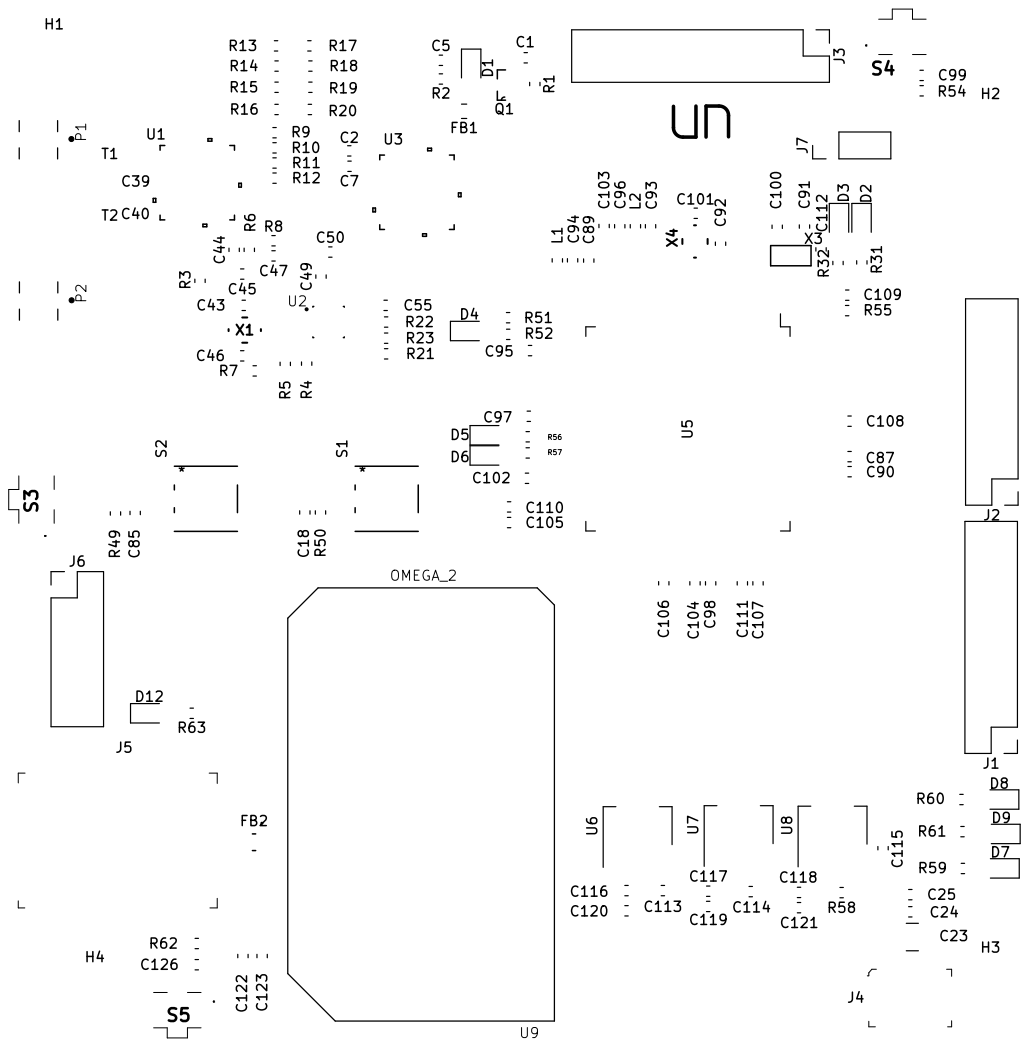
[picture p29: page 1]
