leoperezlievano/SDR_UN/HW/shield_SDR_UN/shield_SDR_UN.kicad_pcb

## KiCad design HW/shield_SDR_UN/shield_SDR_UN.kicad_pcb (2019-06-09)

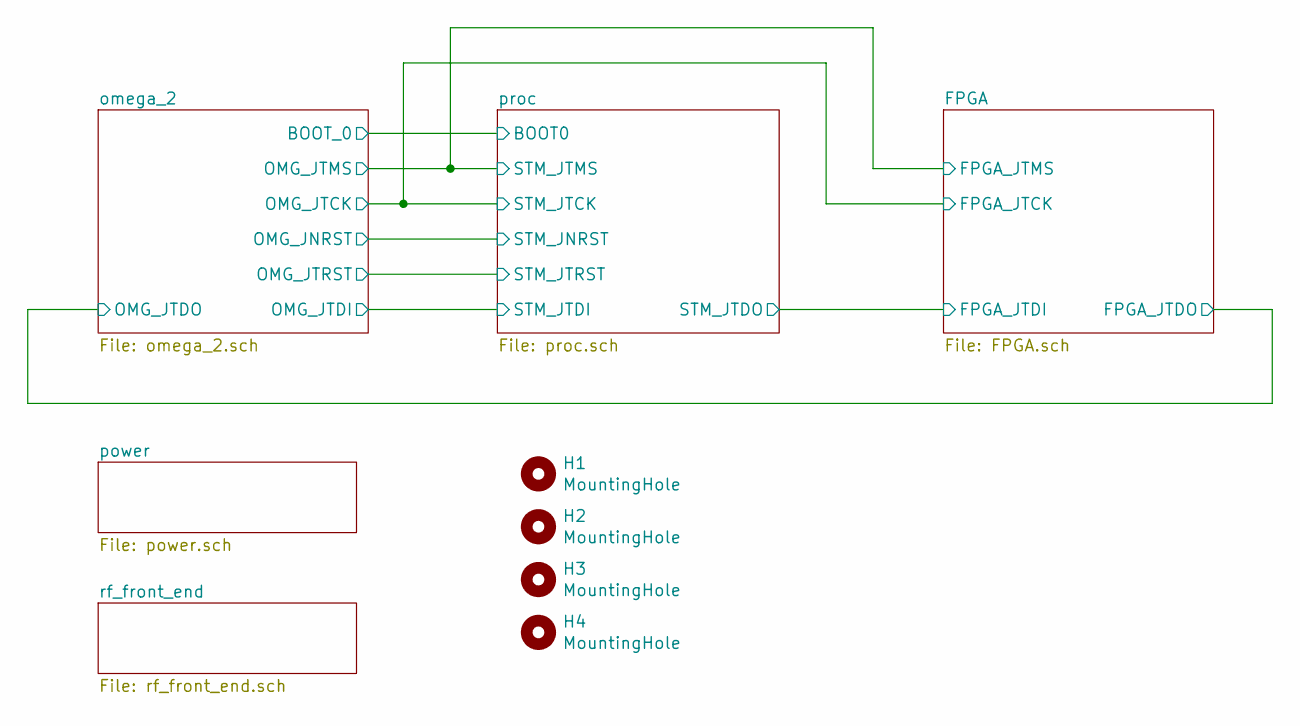
[picture p30: schematic shield_SDR_UN.sch]

Parts:
H1, H2, H3, H4: MountingHole; MountingHole_2.7mm_M2.5_ISO14580_Pad

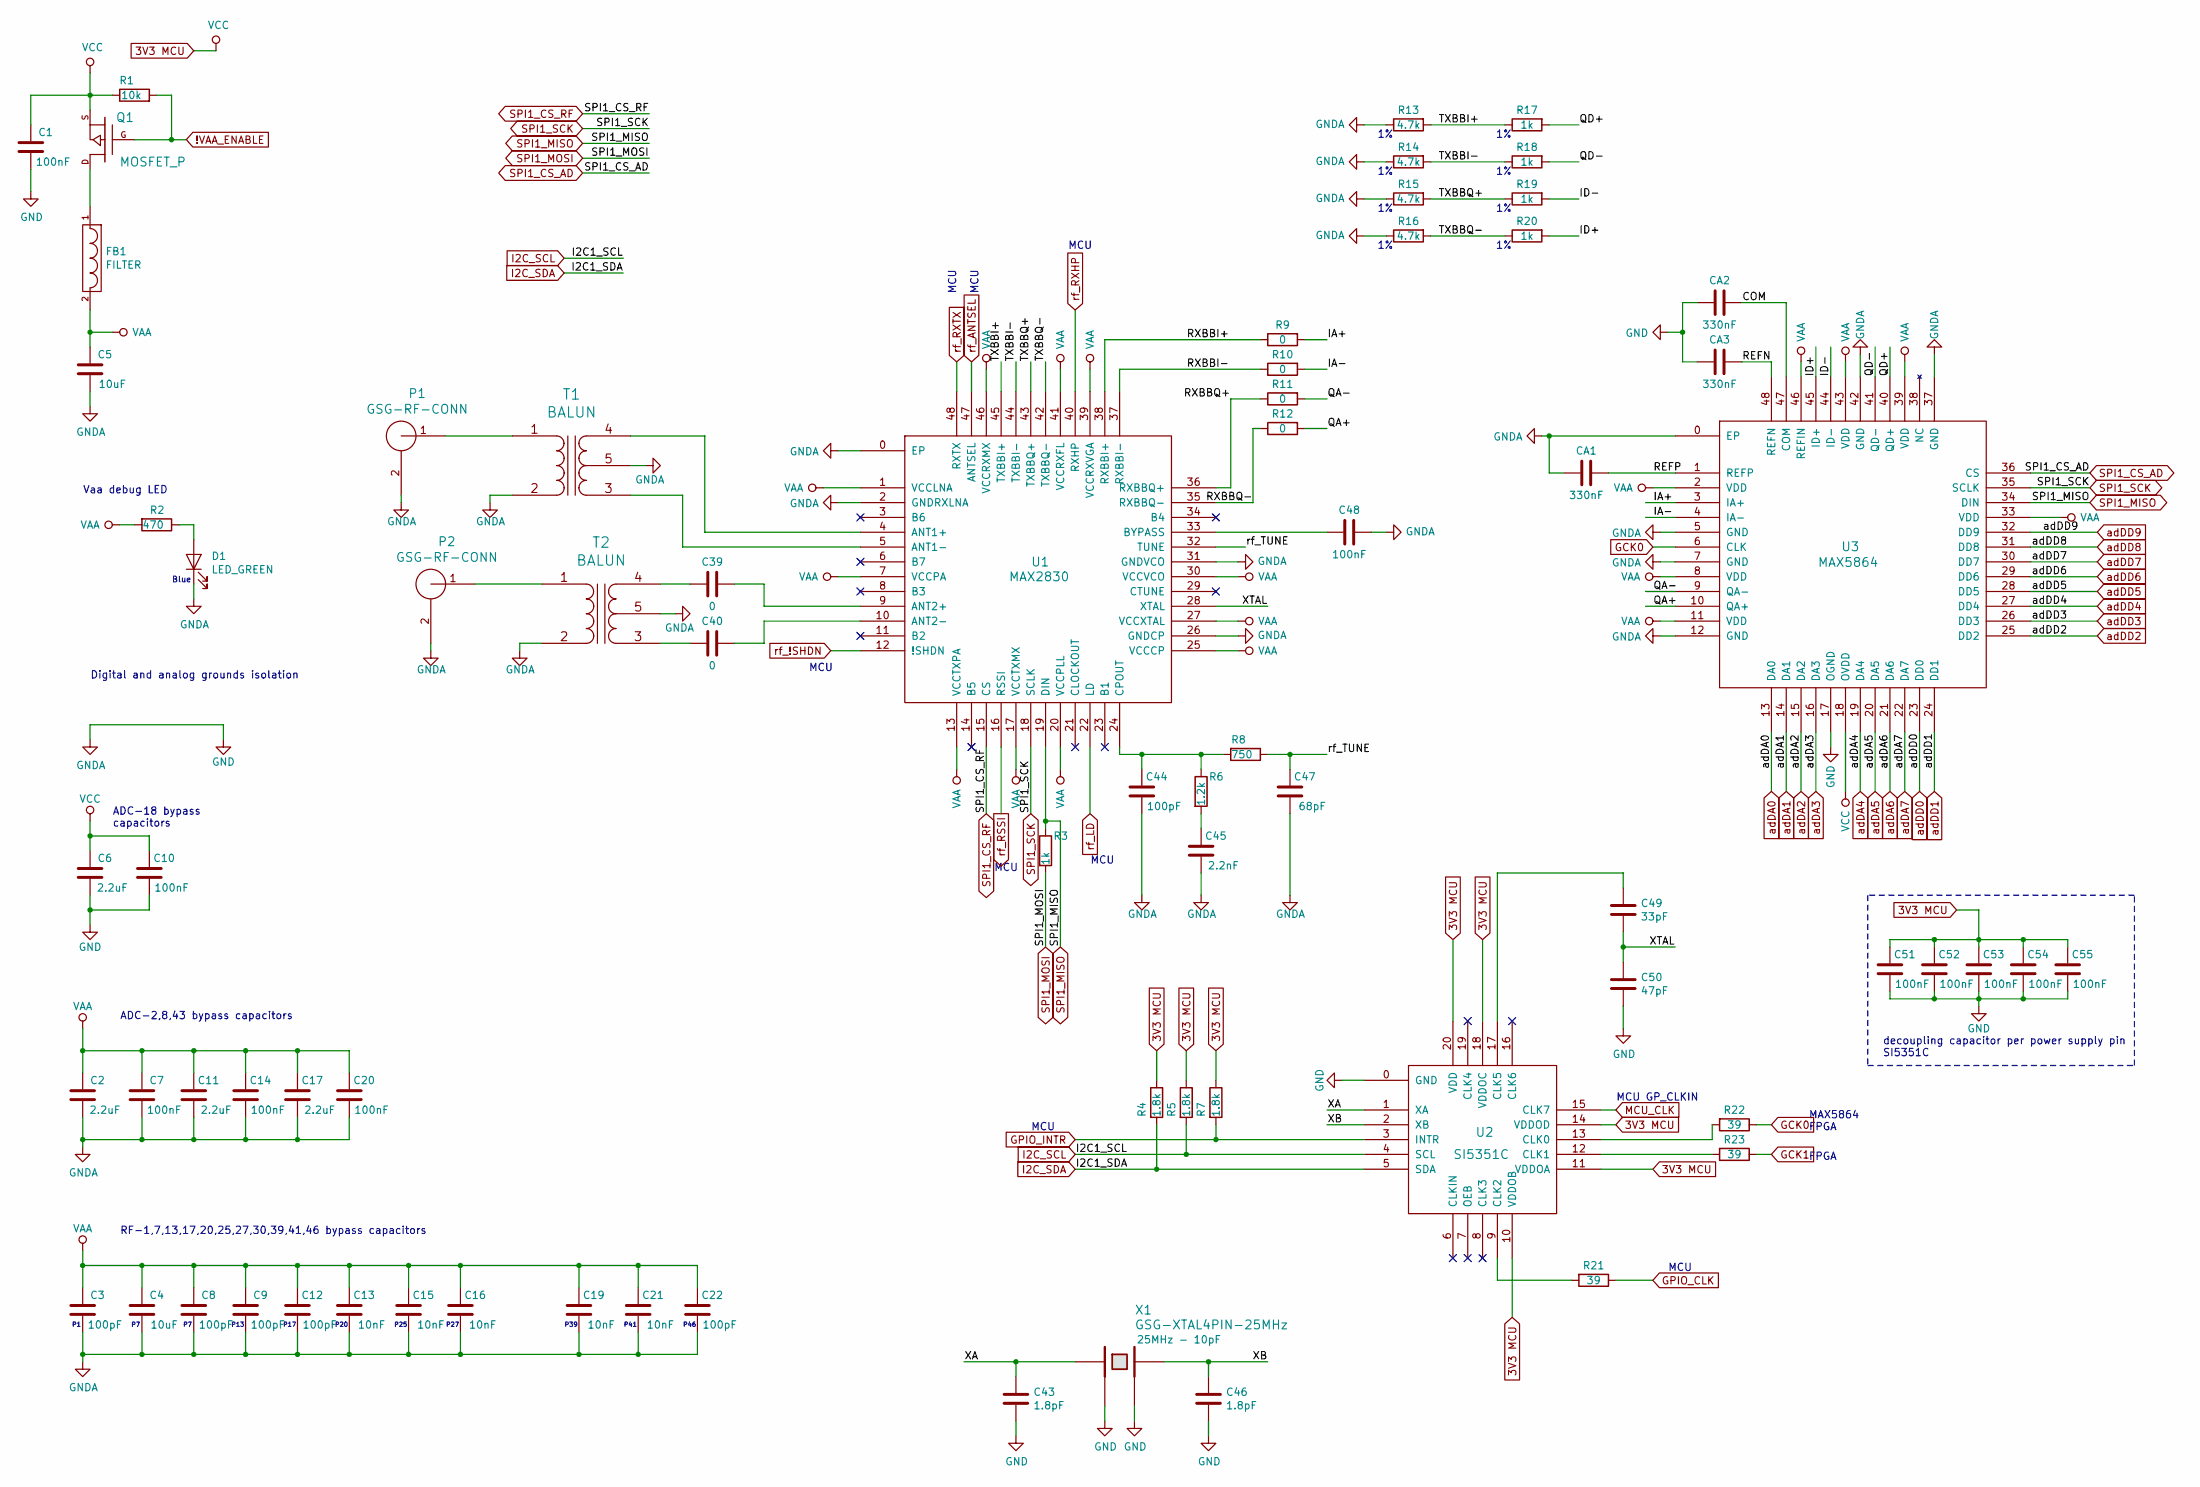
[picture p31: schematic rf_front_end.sch]

Parts:
C1, C7, C10, C14, C20, C48, C51, C52, C53, C54, C55: 100nF; C_0603_1608Metric_Pad1.05x0.95mm_HandSolder; Digikey 1276-1000-1-ND
C2, C6, C11, C17: 2.2uF; C_0603_1608Metric_Pad1.05x0.95mm_HandSolder; Digikey 1276-1085-1-ND
C3, C8, C9, C12, C22, C44: 100pF; C_0603_1608Metric_Pad1.05x0.95mm_HandSolder; Digikey 1276-1909-1-ND
C4, C5: 10uF; C_0603_1608Metric_Pad1.05x0.95mm_HandSolder; Digikey 1276-1192-1-ND
C13, C15, C16, C19, C21: 10nF; C_0603_1608Metric_Pad1.05x0.95mm_HandSolder; Digikey 1276-1009-1-ND
C39, C40: 0; C_0402_1005Metric; Digikey 311-0.0JRCT-ND
C43, C46: 1.8pF; C_0603_1608Metric_Pad1.05x0.95mm_HandSolder; Digikey 1276-2218-1-ND
C45: 2.2nF; C_0603_1608Metric_Pad1.05x0.95mm_HandSolder; Digikey 1276-1987-1-ND
C47: 68pF; C_0603_1608Metric_Pad1.05x0.95mm_HandSolder; Digikey 1276-6538-1-ND
C49: 33pF; C_0603_1608Metric_Pad1.05x0.95mm_HandSolder; Digikey 1276-1070-1-ND
C50: 47pF; C_0603_1608Metric_Pad1.05x0.95mm_HandSolder; Digikey 1276-1037-1-ND
CA1, CA2, CA3: 330nF; C_0603_1608Metric_Pad1.05x0.95mm_HandSolder; Digikey 1276-2048-1-ND
D1: LED_GREEN; LED_0805_2012Metric_Pad1.15x1.40mm_HandSolder; Digikey 160-1468-1-ND
FB1: FILTER; L_0805_2012Metric_Pad1.15x1.40mm_HandSolder; Digikey BLM21PG221SN1D
P1, P2: GSG-RF-CONN; TAOGLAS_EMPCB.SMAFSTJ.B.HT; Digikey CON-SMA-EDGE-S-ND
Q1: MOSFET_P; SOT103P240X110-3N; Digikey DMP2305UDICT-ND
R1: 10k; R_0603_1608Metric_Pad1.05x0.95mm_HandSolder; Digikey 311-10KGRCT-ND
R2: 470; R_0603_1608Metric_Pad1.05x0.95mm_HandSolder; Digikey 311-470GRCT-ND
R3, R17, R18, R19, R20: 1k; R_0603_1608Metric_Pad1.05x0.95mm_HandSolder; Digikey 311-1.00KHRCT-ND
R4, R5, R7: 1.8k; R_0603_1608Metric_Pad1.05x0.95mm_HandSolder; Digikey 311-1.8KGRTR-ND
R6: 1.2k; R_0603_1608Metric_Pad1.05x0.95mm_HandSolder; Digikey 311-1.20KHRCT-ND
R8: 750; R_0603_1608Metric_Pad1.05x0.95mm_HandSolder; Digikey 311-750HRCT-ND
R9, R10, R11, R12: 0; R_0603_1608Metric_Pad1.05x0.95mm_HandSolder; Digikey RMCF0603ZT0R00CT-ND
R13, R14, R15, R16: 4.7k; R_0603_1608Metric_Pad1.05x0.95mm_HandSolder; Digikey 311-4.70KHRCT-ND
R21: 39; R_0603_1608Metric_Pad1.05x0.95mm_HandSolder; part numer RC0603FR-0739RL; digikey 311-39.0HRCT-ND
R22, R23: 39; R_0603_1608Metric_Pad1.05x0.95mm_HandSolder; part numer RC0603FR-0739RL; Digikey 311-39.0HRCT-ND
T1, T2: BALUN; HHM1711E1; Digikey 445-172632-1-ND
U1: MAX2830; MAX2830ETM&plus_; Digikey MAX2830ETM+TCT-ND
U2: SI5351C; QFN50P300X300X60-21N; Digikey 336-5160-1-ND
U3: MAX5864; MAX5864ETM&plus_; Digikey MAX5864ETM+-ND
X1: GSG-XTAL4PIN-25MHz; GSG-XTAL3.2x2.5mm; Digikey 535-13468-1-ND

Connections:
3V3 MCU: C1.1, C6.1, C10.1, C51.1, C52.1, C53.1, C54.1, C55.1, Q1.S, R1.1, R4.1, R5.1, R7.1, U2.10 (VDDOB), U2.11 (VDDOA), U2.14 (VDDOD), U2.18 (VDDOC), U2.20 (VDD), U3.18 (OVDD); also elsewhere on the board
!VAA_ENABLE: Q1.G, R1.2; also elsewhere on the board
/rf_front_end/COM: CA2.1, U3.47 (COM)
/rf_front_end/IA+: R9.2, U3.3 (IA+)
/rf_front_end/IA-: R10.2, U3.4 (IA-)
/rf_front_end/ID+: R20.2, U3.45 (ID+)
/rf_front_end/ID-: R19.2, U3.44 (ID-)
/rf_front_end/QA+: R12.2, U3.10 (QA+)
/rf_front_end/QA-: R11.2, U3.9 (QA-)
/rf_front_end/QD+: R17.2, U3.40 (QD+)
/rf_front_end/QD-: R18.2, U3.41 (QD-)
/rf_front_end/REFN: CA3.1, U3.48 (REFN)
/rf_front_end/REFP: CA1.1, U3.1 (REFP)
/rf_front_end/RXBBI+: R9.1, U1.38 (RXBBI+)
/rf_front_end/RXBBI-: R10.1, U1.37 (RXBBI-)
/rf_front_end/RXBBQ+: R11.1, U1.36 (RXBBQ+)
/rf_front_end/RXBBQ-: R12.1, U1.35 (RXBBQ-)
/rf_front_end/TXBBI+: R13.2, R17.1, U1.45 (TXBBI+)
/rf_front_end/TXBBI-: R14.2, R18.1, U1.44 (TXBBI-)
/rf_front_end/TXBBQ+: R15.2, R19.1, U1.43 (TXBBQ+)
/rf_front_end/TXBBQ-: R16.2, R20.1, U1.42 (TXBBQ-)
/rf_front_end/XA: C43.1, U2.1 (XA), X1.1
/rf_front_end/XB: C46.1, U2.2 (XB), X1.3
/rf_front_end/XTAL: C49.2, C50.1, U1.28 (XTAL)
/rf_front_end/rf_TUNE: C47.2, R8.1, U1.32 (TUNE)
GCK0: R22.1, U3.6 (CLK); also elsewhere on the board
GCK1: R23.1; also elsewhere on the board
GND: C1.2, C2.2, C3.2, C4.2, C5.2, C6.2, C7.2, C8.2, C9.2, C10.2, C11.2, C12.2, C13.2, C14.2, C15.2, C16.2, C17.2, C19.2, C20.2, C21.2, C22.2, C43.2, C44.1, C45.1, C46.2, C47.1, C48.1, C50.2, C51.2, C52.2, C53.2, C54.2, C55.2, CA1.2, CA2.2, CA3.2, D1.1 (K), P1.2 (GND), P2.2 (GND), R13.1, R14.1, R15.1, R16.1, T1.2 (S2), T1.5 (PM), T2.2 (S2), T2.5 (PM), U1.0 (EP), U1.2 (GNDRXLNA), U1.26 (GNDCP), U1.31 (GNDVCO), U2.0 (GND), U3.0 (EP), U3.5 (GND), U3.7 (GND), U3.12 (GND), U3.17 (OGND), U3.37 (GND), U3.42 (GND), X1.2, X1.4; also elsewhere on the board
GPIO_CLK: R21.1; also elsewhere on the board
GPIO_INTR: R7.2, U2.3 (INTR); also elsewhere on the board
I2C_SCL: R5.2, U2.4 (SCL); also elsewhere on the board
I2C_SDA: R4.2, U2.5 (SDA); also elsewhere on the board
MCU_CLK: U2.15 (CLK7); also elsewhere on the board
unnamed: C39.1, U1.9 (ANT2+)
unnamed: C39.2, T2.4 (PR2)
unnamed: C40.1, U1.10 (ANT2-)
unnamed: C40.2, T2.3 (PR1)
unnamed: C44.2, R6.1, R8.2, U1.24 (CPOUT)
unnamed: C45.2, R6.2
unnamed: C48.2, U1.33 (BYPASS)
unnamed: C49.1, U2.17 (CLK5)
unnamed: D1.2 (A), R2.1
unnamed: FB1.1, Q1.D
unnamed: P1.1 (RF), T1.1 (S1)
unnamed: P2.1 (RF), T2.1 (S1)
unnamed: R21.2, U2.9 (CLK2)
unnamed: R22.2, U2.13 (CLK0)
unnamed: R23.2, U2.12 (CLK1)
unnamed: T1.3 (PR1), U1.5 (ANT1-)
unnamed: T1.4 (PR2), U1.4 (ANT1+)
SPI1_CS_AD: U3.36 (CS); also elsewhere on the board
SPI1_CS_RF: U1.15 (CS); also elsewhere on the board
SPI1_MISO: R3.1, U1.19 (DIN), U3.34 (DIN); also elsewhere on the board
SPI1_MOSI: R3.2; also elsewhere on the board
SPI1_SCK: U1.18 (SCLK), U3.35 (SCLK); also elsewhere on the board
VAA: C2.1, C3.1, C4.1, C5.1, C7.1, C8.1, C9.1, C11.1, C12.1, C13.1, C14.1, C15.1, C16.1, C17.1, C19.1, C20.1, C21.1, C22.1, FB1.2, R2.2, U1.1 (VCCLNA), U1.7 (VCCPA), U1.13 (VCCTXPA), U1.17 (VCCTXMX), U1.20 (VCCPLL), U1.25 (VCCCP), U1.27 (VCCXTAL), U1.30 (VCCVCO), U1.39 (VCCRXVGA), U1.41 (VCCRXFL), U1.46 (VCCRXMX), U3.2 (VDD), U3.8 (VDD), U3.11 (VDD), U3.33 (VDD), U3.39 (VDD), U3.43 (VDD), U3.46 (REFIN)
adDA0: U3.13 (DA0); also elsewhere on the board
adDA1: U3.14 (DA1); also elsewhere on the board
adDA2: U3.15 (DA2); also elsewhere on the board
adDA3: U3.16 (DA3); also elsewhere on the board
adDA4: U3.19 (DA4); also elsewhere on the board
adDA5: U3.20 (DA5); also elsewhere on the board
adDA6: U3.21 (DA6); also elsewhere on the board
adDA7: U3.22 (DA7); also elsewhere on the board
adDD0: U3.23 (DD0); also elsewhere on the board
adDD1: U3.24 (DD1); also elsewhere on the board
adDD2: U3.25 (DD2); also elsewhere on the board
adDD3: U3.26 (DD3); also elsewhere on the board
adDD4: U3.27 (DD4); also elsewhere on the board
adDD5: U3.28 (DD5); also elsewhere on the board
adDD6: U3.29 (DD6); also elsewhere on the board
adDD7: U3.30 (DD7); also elsewhere on the board
adDD8: U3.31 (DD8); also elsewhere on the board
adDD9: U3.32 (DD9); also elsewhere on the board
rf_!SHDN: U1.12 (!SHDN); also elsewhere on the board
rf_ANTSEL: U1.47 (ANTSEL); also elsewhere on the board
rf_LD: U1.22 (LD); also elsewhere on the board
rf_RSSI: U1.16 (RSSI); also elsewhere on the board
rf_RXHP: U1.40 (RXHP); also elsewhere on the board
rf_RXTX: U1.48 (RXTX); also elsewhere on the board

Notes on the sheet:
ADC-18 bypass capacitors
ADC-2,8,43 bypass capacitors
Vaa debug LED
Digital and analog grounds isolation
RF-1,7,13,17,20,25,27,30,39,41,46 bypass capacitors
MCU
FPGA
MAX5864 FPGA
MCU GP_CLKIN
Blue
decoupling capacitor per power supply pin SI5351C
MCU
P13
P17
P20
P25
P27
P39
P41
P46

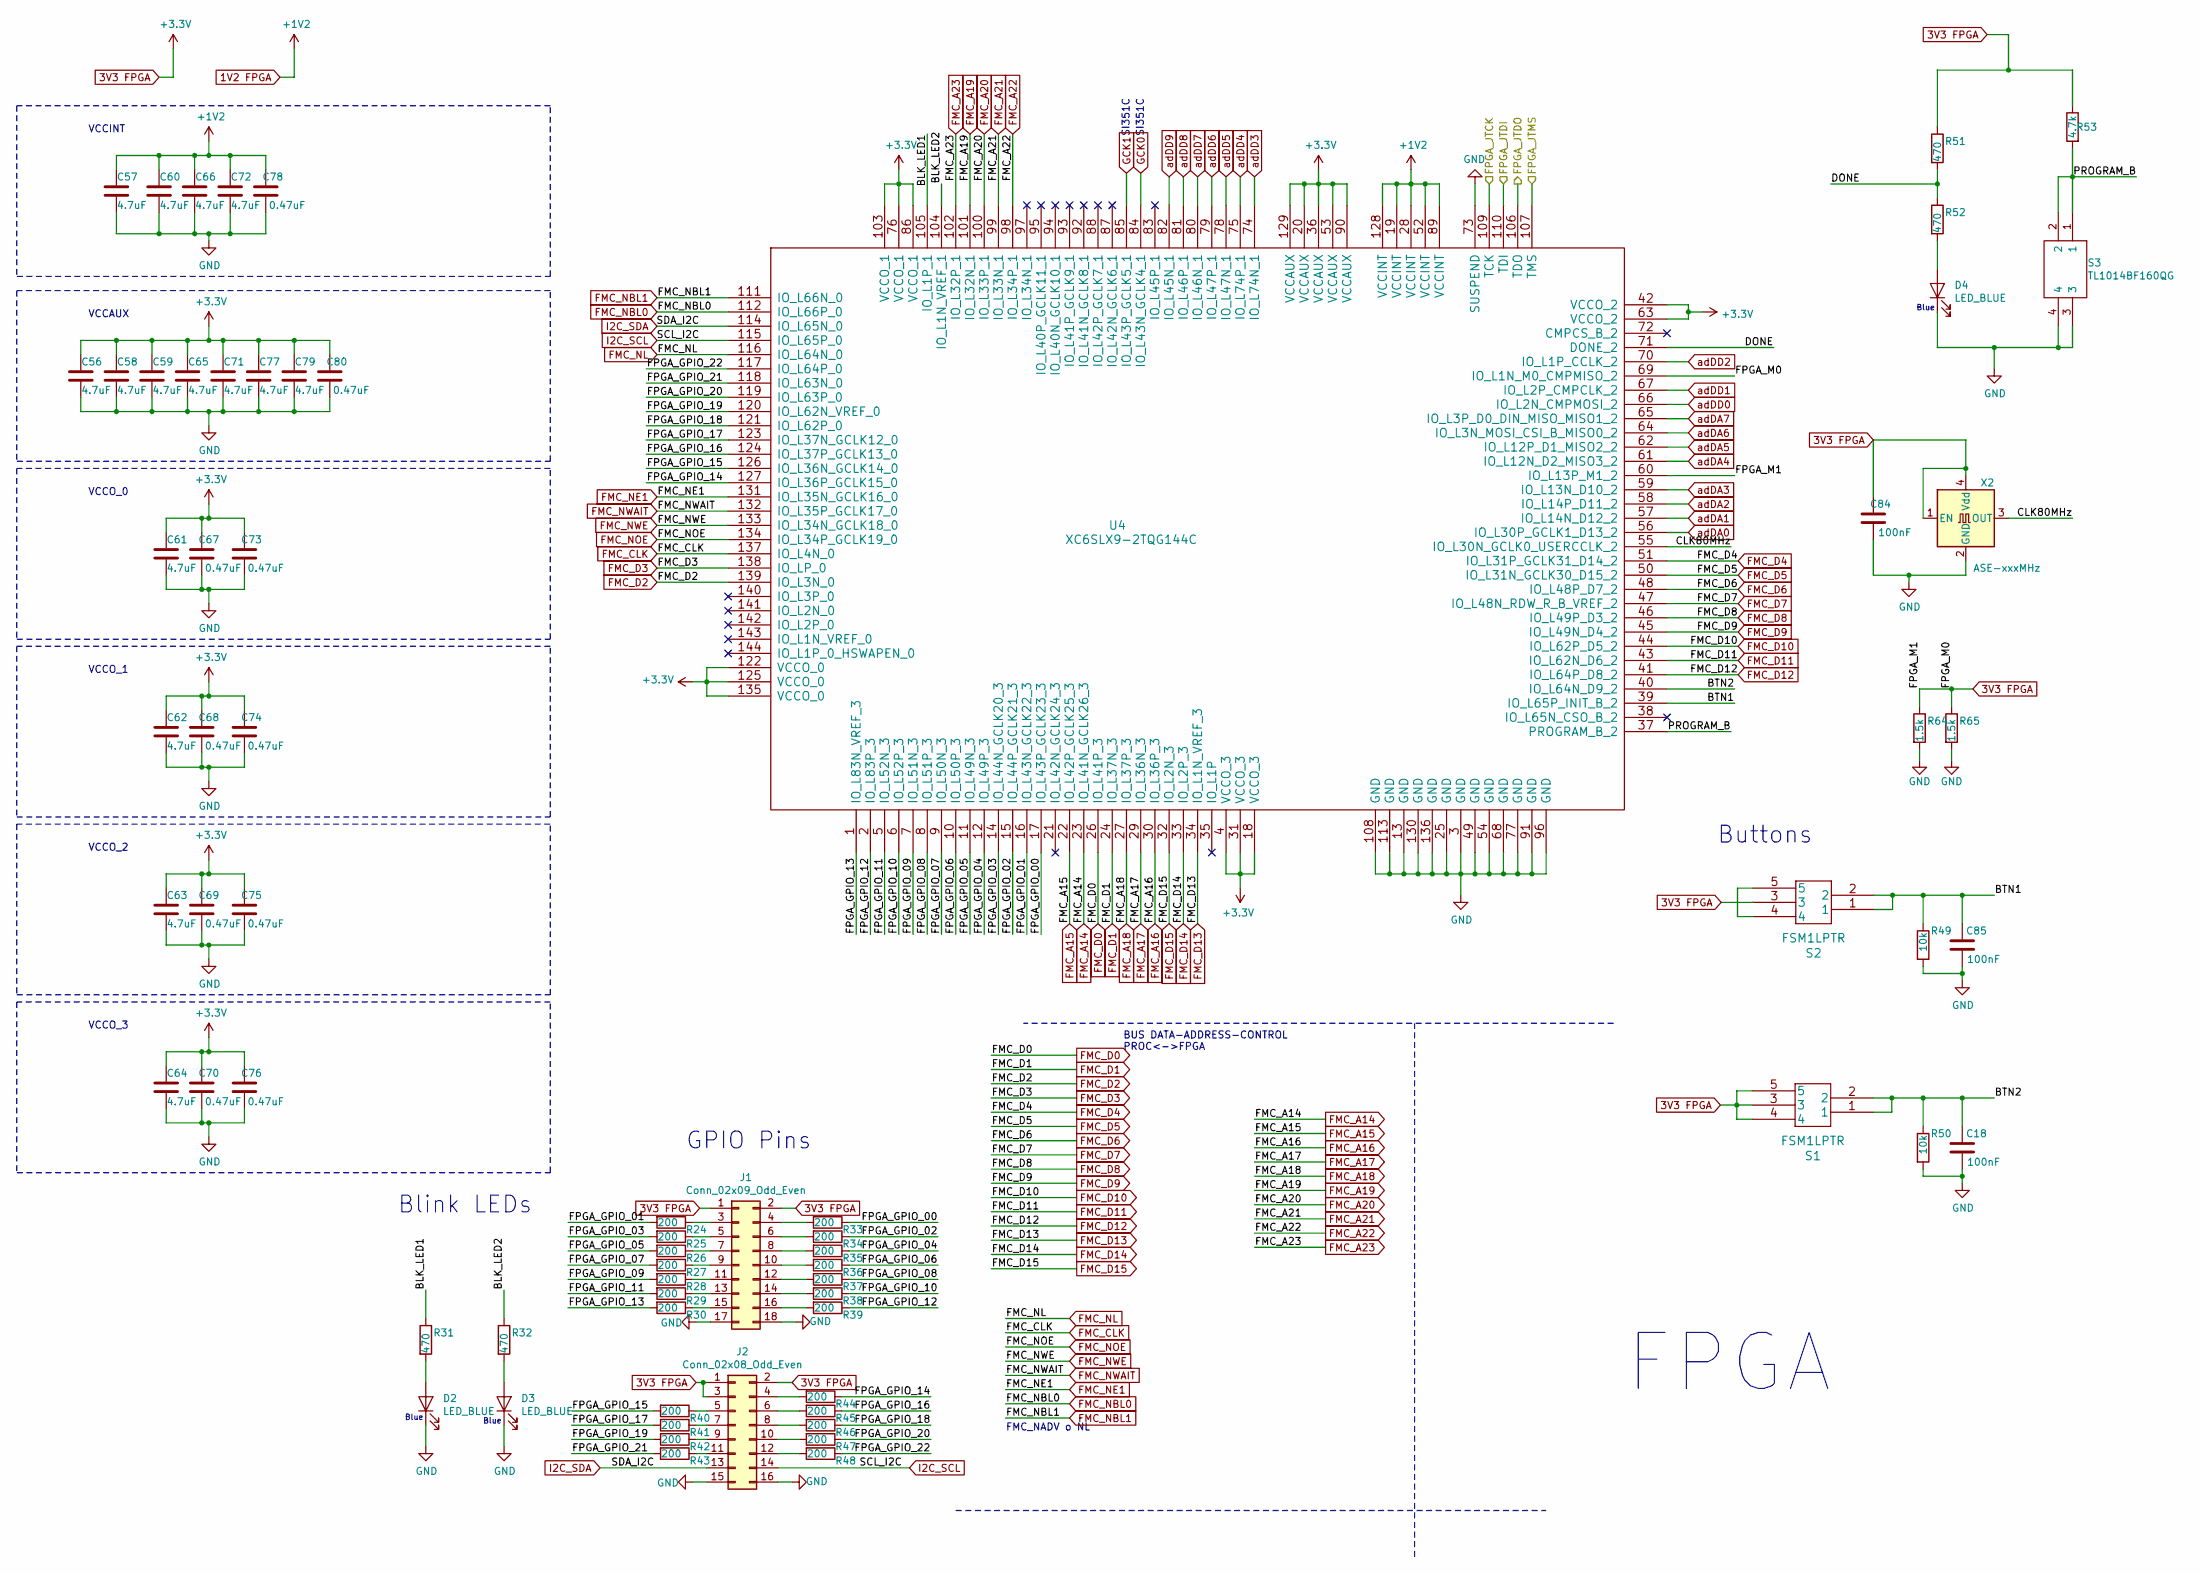
[picture p32: schematic FPGA.sch]

Parts:
C18, C84, C85: 100nF; C_0603_1608Metric_Pad1.05x0.95mm_HandSolder; Digikey 1276-1000-1-ND
C56, C57, C58, C59, C60, C61, C62, C63, C64, C65, C66, C71, C72, C77, C79: 4.7uF; C_0603_1608Metric_Pad1.05x0.95mm_HandSolder; Digikey 1276-1045-1-ND
C67, C68, C69, C70, C73, C74, C75, C76, C78, C80: 0.47uF; C_0603_1608Metric_Pad1.05x0.95mm_HandSolder; Digikey 1276-2082-1-ND
D2, D3, D4: LED_BLUE; LED_0805_2012Metric_Pad1.15x1.40mm_HandSolder; Digikey 160-2032-1-ND
J1: Conn_02x09_Odd_Even; PinHeader_2x09_P2.54mm_Vertical; Digikey 609-6336-ND
J2: Conn_02x08_Odd_Even; PinHeader_2x08_P2.54mm_Vertical; Digikey 609-6336-ND
R24, R25, R26, R27, R28, R29, R30, R33, R34, R35, R36, R37, R38, R39, R40, R41, R42, R43, R44, R45, R46, R47, R48: 200; R_0603_1608Metric_Pad1.05x0.95mm_HandSolder; Digikey 311-200GRCT-ND
R31, R32, R51, R52: 470; R_0603_1608Metric_Pad1.05x0.95mm_HandSolder; Digikey 311-470GRCT-ND
R49, R50: 10k; R_0603_1608Metric_Pad1.05x0.95mm_HandSolder; Digikey 311-10KGRCT-ND
R53: 4.7k; R_0603_1608Metric_Pad1.05x0.95mm_HandSolder; Digikey 311-4.70KHRCT-ND
R64, R65: 1.5k; R_0603_1608Metric_Pad1.05x0.95mm_HandSolder; Digikey 311-1.5KGRCT-ND
S1, S2: FSM1LPTR; Digikey 450-1756-1-ND
S3: TL1014BF160QG; Digikey EG5042CT-ND
U4: XC6SLX9-2TQG144C; LQFP-144_20x20mm_P0.5mm; Digikey 122-1745-ND
X2: ASE-xxxMHz; Oscillator_SMD_Abracon_ASE-4Pin_3.2x2.5mm_HandSoldering; Digikey 535-11114-1-ND

Connections:
1V2 FPGA: C57.1, C60.1, C66.1, C72.1, C78.1, U4.19 (VCCINT), U4.28 (VCCINT), U4.52 (VCCINT), U4.89 (VCCINT), U4.128 (VCCINT); also elsewhere on the board
3V3 FPGA: C56.1, C58.1, C59.1, C61.1, C62.1, C63.1, C64.1, C65.1, C67.1, C68.1, C69.1, C70.1, C71.1, C73.1, C74.1, C75.1, C76.1, C77.1, C79.1, C80.1, C84.1, J1.1, J1.2, J2.1, J2.2, J2.3, R51.1, R53.1, R64.1, R65.1, S1.3, S1.4, S1.5, S2.3, U4.4 (VCCO_3), U4.18 (VCCO_3), U4.20 (VCCAUX), U4.31 (VCCO_3), U4.36 (VCCAUX), U4.42 (VCCO_2), U4.53 (VCCAUX), U4.60 (IO_L13P_M1_2), U4.63 (VCCO_2), U4.69 (IO_L1N_M0_CMPMISO_2), U4.76 (VCCO_1), U4.86 (VCCO_1), U4.90 (VCCAUX), U4.103 (VCCO_1), U4.122 (VCCO_0), U4.125 (VCCO_0), U4.129 (VCCAUX), U4.135 (VCCO_0), X2.1 (EN), X2.4 (Vdd); also elsewhere on the board
/FPGA/BLK_LED1: R31.1, U4.105 (IO_L1P_1)
/FPGA/BLK_LED2: R32.1, U4.104 (IO_L1N_VREF_1)
/FPGA/BTN1: C85.1, R49.1, S2.1, S2.2, U4.39 (IO_L65P_INIT_B_2)
/FPGA/BTN2: C18.1, R50.1, S1.1, S1.2, U4.40 (IO_L64N_D9_2)
/FPGA/CLK80MHz: U4.55 (IO_L30N_GCLK0_USERCCLK_2), X2.3 (OUT)
/FPGA/DONE: R51.2, R52.1, U4.71 (DONE_2)
/FPGA/FPGA_GPIO_00: R33.1, U4.17 (IO_L43P_GCLK23_3)
/FPGA/FPGA_GPIO_01: R24.2, U4.16 (IO_L43N_GCLK22_3)
/FPGA/FPGA_GPIO_02: R34.1, U4.15 (IO_L44P_GCLK21_3)
/FPGA/FPGA_GPIO_03: R25.2, U4.14 (IO_L44N_GCLK20_3)
/FPGA/FPGA_GPIO_04: R35.1, U4.12 (IO_L49P_3)
/FPGA/FPGA_GPIO_05: R26.2, U4.11 (IO_L49N_3)
/FPGA/FPGA_GPIO_06: R36.1, U4.10 (IO_L50P_3)
/FPGA/FPGA_GPIO_07: R27.2, U4.9 (IO_L50N_3)
/FPGA/FPGA_GPIO_08: R37.1, U4.8 (IO_L51P_3)
/FPGA/FPGA_GPIO_09: R28.2, U4.7 (IO_L51N_3)
/FPGA/FPGA_GPIO_10: R38.1, U4.6 (IO_L52P_3)
/FPGA/FPGA_GPIO_11: R29.2, U4.5 (IO_L52N_3)
/FPGA/FPGA_GPIO_12: R39.1, U4.2 (IO_L83P_3)
/FPGA/FPGA_GPIO_13: R30.2, U4.1 (IO_L83N_VREF_3)
/FPGA/FPGA_GPIO_14: R44.1, U4.127 (IO_L36P_GCLK15_0)
/FPGA/FPGA_GPIO_15: R40.2, U4.126 (IO_L36N_GCLK14_0)
/FPGA/FPGA_GPIO_16: R45.1, U4.124 (IO_L37P_GCLK13_0)
/FPGA/FPGA_GPIO_17: R41.2, U4.123 (IO_L37N_GCLK12_0)
/FPGA/FPGA_GPIO_18: R46.1, U4.121 (IO_L62P_0)
/FPGA/FPGA_GPIO_19: R42.2, U4.120 (IO_L62N_VREF_0)
/FPGA/FPGA_GPIO_20: R47.1, U4.119 (IO_L63P_0)
/FPGA/FPGA_GPIO_21: R43.2, U4.118 (IO_L63N_0)
/FPGA/FPGA_GPIO_22: R48.1, U4.117 (IO_L64P_0)
/FPGA/PROGRAM_B: R53.2, S3.1, S3.2, U4.37 (PROGRAM_B_2)
/FPGA_JTDO: U4.106 (TDO); also elsewhere on the board
/OMG_JTCK: U4.109 (TCK); also elsewhere on the board
/OMG_JTMS: U4.107 (TMS); also elsewhere on the board
/STM_JTDO: U4.110 (TDI); also elsewhere on the board
FMC_A14: U4.23 (IO_L41N_GCLK26_3); also elsewhere on the board
FMC_A15: U4.22 (IO_L42P_GCLK25_3); also elsewhere on the board
FMC_A16: U4.30 (IO_L36P_3); also elsewhere on the board
FMC_A17: U4.29 (IO_L36N_3); also elsewhere on the board
FMC_A18: U4.27 (IO_L37P_3); also elsewhere on the board
FMC_A19: U4.101 (IO_L32N_1); also elsewhere on the board
FMC_A20: U4.100 (IO_L33P_1); also elsewhere on the board
FMC_A21: U4.99 (IO_L33N_1); also elsewhere on the board
FMC_A22: U4.98 (IO_L34P_1); also elsewhere on the board
FMC_A23: U4.102 (IO_L32P_1); also elsewhere on the board
FMC_CLK: U4.137 (IO_L4N_0); also elsewhere on the board
FMC_D0: U4.26 (IO_L41P_3); also elsewhere on the board
FMC_D1: U4.24 (IO_L37N_3); also elsewhere on the board
FMC_D2: U4.139 (IO_L3N_0); also elsewhere on the board
FMC_D3: U4.138 (IO_LP_0); also elsewhere on the board
FMC_D4: U4.51 (IO_L31P_GCLK31_D14_2); also elsewhere on the board
FMC_D5: U4.50 (IO_L31N_GCLK30_D15_2); also elsewhere on the board
FMC_D6: U4.48 (IO_L48P_D7_2); also elsewhere on the board
FMC_D7: U4.47 (IO_L48N_RDW_R_B_VREF_2); also elsewhere on the board
FMC_D8: U4.46 (IO_L49P_D3_2); also elsewhere on the board
FMC_D9: U4.45 (IO_L49N_D4_2); also elsewhere on the board
FMC_D10: U4.44 (IO_L62P_D5_2); also elsewhere on the board
FMC_D11: U4.43 (IO_L62N_D6_2); also elsewhere on the board
FMC_D12: U4.41 (IO_L64P_D8_2); also elsewhere on the board
FMC_D13: U4.34 (IO_L1N_VREF_3); also elsewhere on the board
FMC_D14: U4.33 (IO_L2P_3); also elsewhere on the board
FMC_D15: U4.32 (IO_L2N_3); also elsewhere on the board
FMC_NBL0: U4.112 (IO_L66P_0); also elsewhere on the board
FMC_NBL1: U4.111 (IO_L66N_0); also elsewhere on the board
FMC_NE1: U4.131 (IO_L35N_GCLK16_0); also elsewhere on the board
FMC_NL: U4.116 (IO_L64N_0); also elsewhere on the board
FMC_NOE: U4.134 (IO_L34P_GCLK19_0); also elsewhere on the board
FMC_NWAIT: U4.132 (IO_L35P_GCLK17_0); also elsewhere on the board
FMC_NWE: U4.133 (IO_L34N_GCLK18_0); also elsewhere on the board
GCK0: U4.84 (IO_L43N_GCLK4_1); also elsewhere on the board
GCK1: U4.85 (IO_L43P_GCLK5_1); also elsewhere on the board
GND: C18.2, C56.2, C57.2, C58.2, C59.2, C60.2, C61.2, C62.2, C63.2, C64.2, C65.2, C66.2, C67.2, C68.2, C69.2, C70.2, C71.2, C72.2, C73.2, C74.2, C75.2, C76.2, C77.2, C78.2, C79.2, C80.2, C84.2, C85.2, D2.1 (K), D3.1 (K), D4.1 (K), J1.17, J1.18, J2.15, J2.16, R49.2, R50.2, R64.2, R65.2, S3.3, S3.4, U4.3 (GND), U4.13 (GND), U4.25 (GND), U4.49 (GND), U4.54 (GND), U4.68 (GND), U4.73 (SUSPEND), U4.77 (GND), U4.91 (GND), U4.96 (GND), U4.108 (GND), U4.113 (GND), U4.130 (GND), U4.136 (GND), X2.2 (GND); also elsewhere on the board
I2C_SCL: J2.14, U4.115 (IO_L65P_0); also elsewhere on the board
I2C_SDA: J2.13, U4.114 (IO_L65N_0); also elsewhere on the board
unnamed: D2.2 (A), R31.2
unnamed: D3.2 (A), R32.2
unnamed: D4.2 (A), R52.2
unnamed: J1.3, R24.1
unnamed: J1.4, R33.2
unnamed: J1.5, R25.1
unnamed: J1.6, R34.2
unnamed: J1.7, R26.1
unnamed: J1.8, R35.2
unnamed: J1.9, R27.1
unnamed: J1.10, R36.2
unnamed: J1.11, R28.1
unnamed: J1.12, R37.2
unnamed: J1.13, R29.1
unnamed: J1.14, R38.2
unnamed: J1.15, R30.1
unnamed: J1.16, R39.2
unnamed: J2.4, R44.2
unnamed: J2.5, R40.1
unnamed: J2.6, R45.2
unnamed: J2.7, R41.1
unnamed: J2.8, R46.2
unnamed: J2.9, R42.1
unnamed: J2.10, R47.2
unnamed: J2.11, R43.1
unnamed: J2.12, R48.2
unnamed: S2.4, S2.5
adDA0: U4.56 (IO_L30P_GCLK1_D13_2); also elsewhere on the board
adDA1: U4.57 (IO_L14N_D12_2); also elsewhere on the board
adDA2: U4.58 (IO_L14P_D11_2); also elsewhere on the board
adDA3: U4.59 (IO_L13N_D10_2); also elsewhere on the board
adDA4: U4.61 (IO_L12N_D2_MISO3_2); also elsewhere on the board
adDA5: U4.62 (IO_L12P_D1_MISO2_2); also elsewhere on the board
adDA6: U4.64 (IO_L3N_MOSI_CSI_B_MISO0_2); also elsewhere on the board
adDA7: U4.65 (IO_L3P_D0_DIN_MISO_MISO1_2); also elsewhere on the board
adDD0: U4.66 (IO_L2N_CMPMOSI_2); also elsewhere on the board
adDD1: U4.67 (IO_L2P_CMPCLK_2); also elsewhere on the board
adDD2: U4.70 (IO_L1P_CCLK_2); also elsewhere on the board
adDD3: U4.74 (IO_L74N_1); also elsewhere on the board
adDD4: U4.75 (IO_L74P_1); also elsewhere on the board
adDD5: U4.78 (IO_L47N_1); also elsewhere on the board
adDD6: U4.79 (IO_L47P_1); also elsewhere on the board
adDD7: U4.80 (IO_L46N_1); also elsewhere on the board
adDD8: U4.81 (IO_L46P_1); also elsewhere on the board
adDD9: U4.82 (IO_L45N_1); also elsewhere on the board

Notes on the sheet:
FPGA
Blink LEDs
GPIO Pins
BUS DATA-ADDRESS-CONTROL PROC<->FPGA
Blue
SI351C
Buttons
FMC_NADV o NL
VCCINT
VCCAUX
VCCO_0
VCCO_1
VCCO_2
VCCO_3
