leoperezlievano/SDR_UN/HW/shield_SDR_UN/shield_SDR_UN.kicad_pcb

## KiCad design HW/shield_SDR_UN/shield_SDR_UN.kicad_pcb (continued)

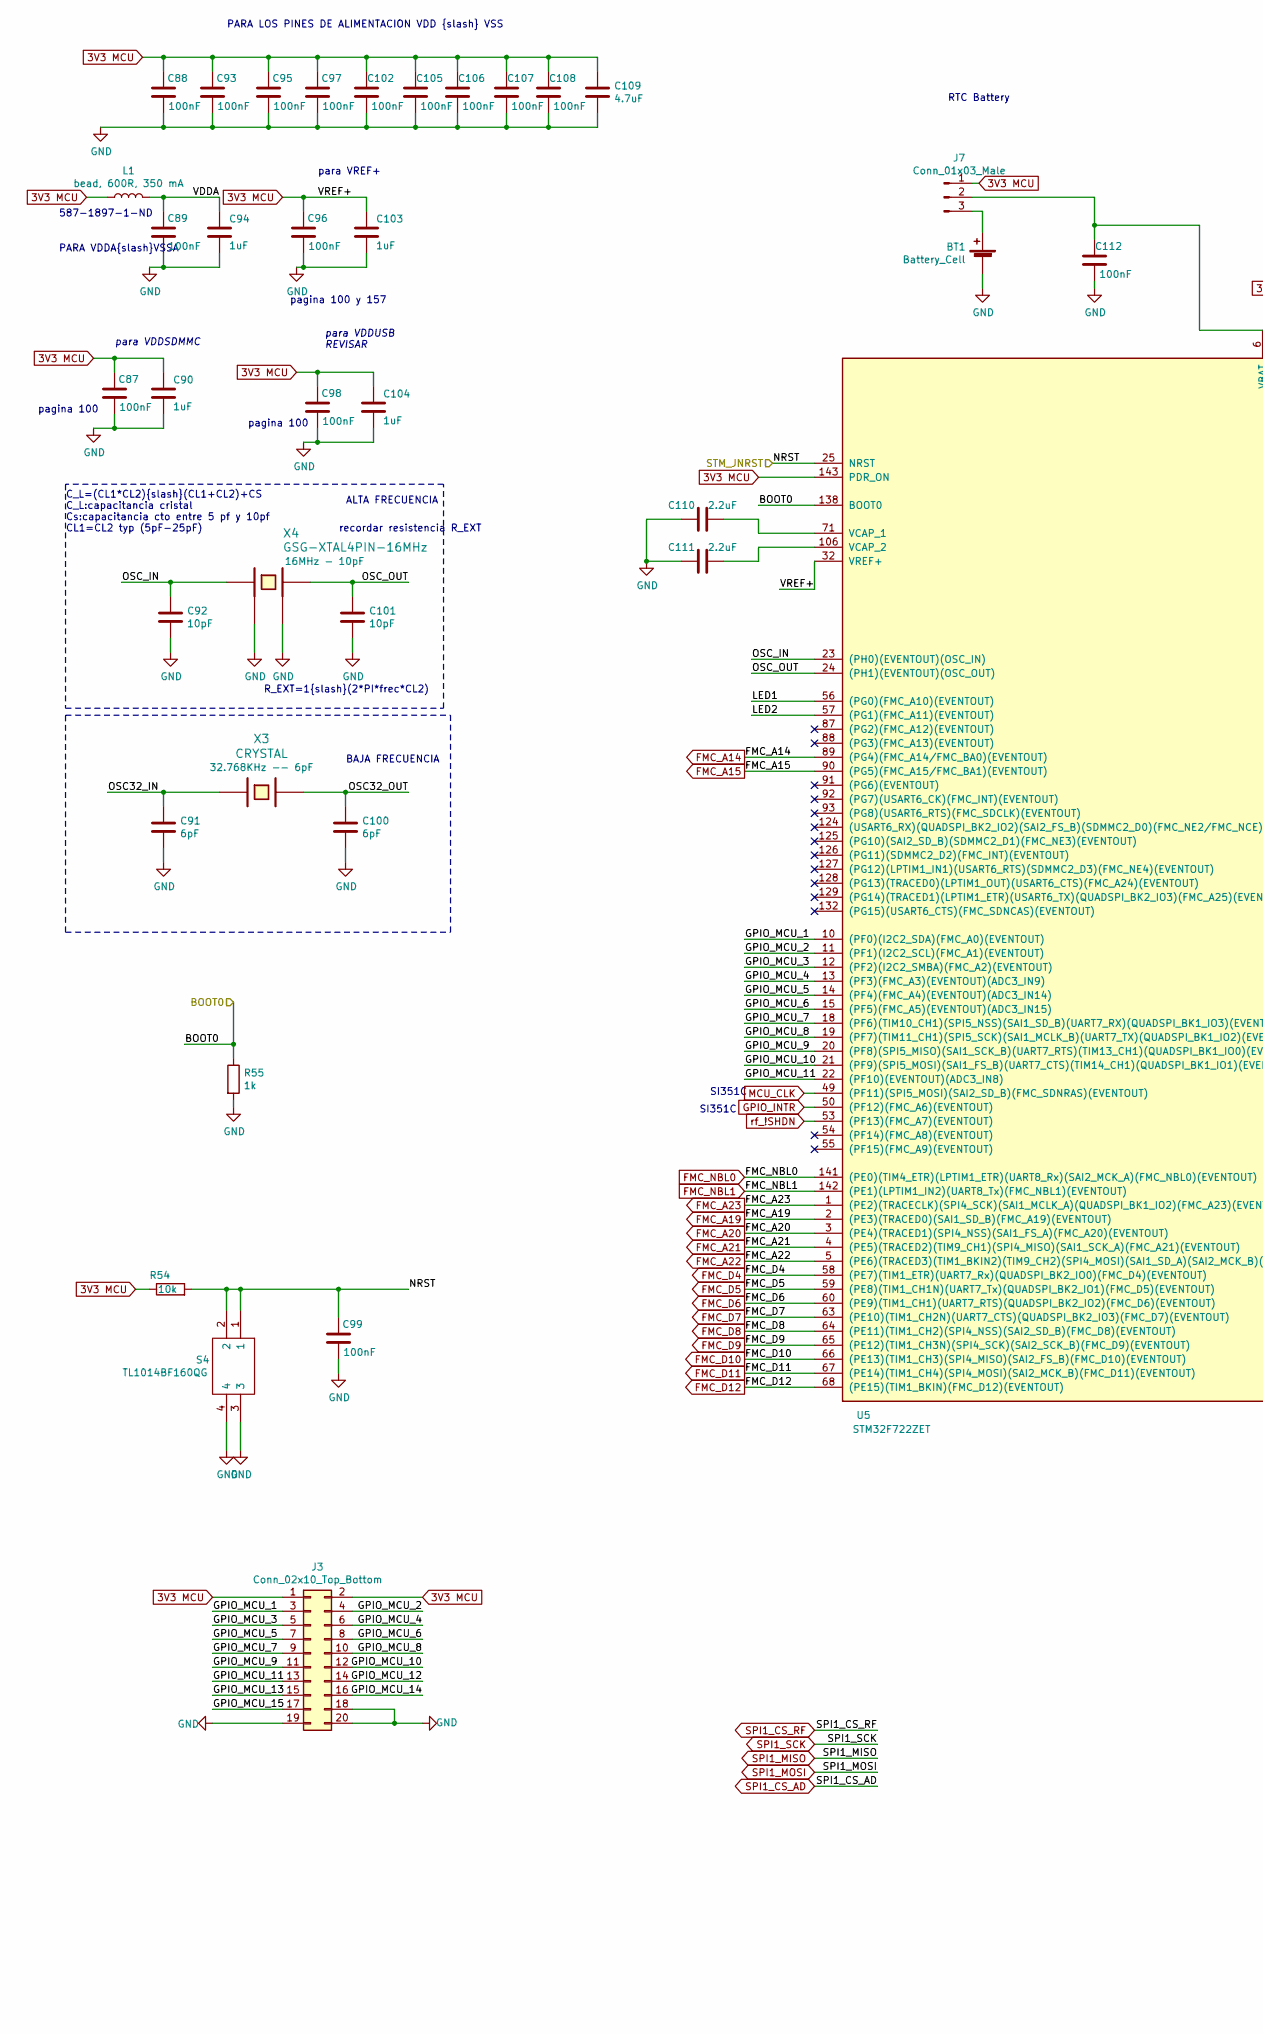
[picture p33: schematic proc.sch, part in row 1, column 1]

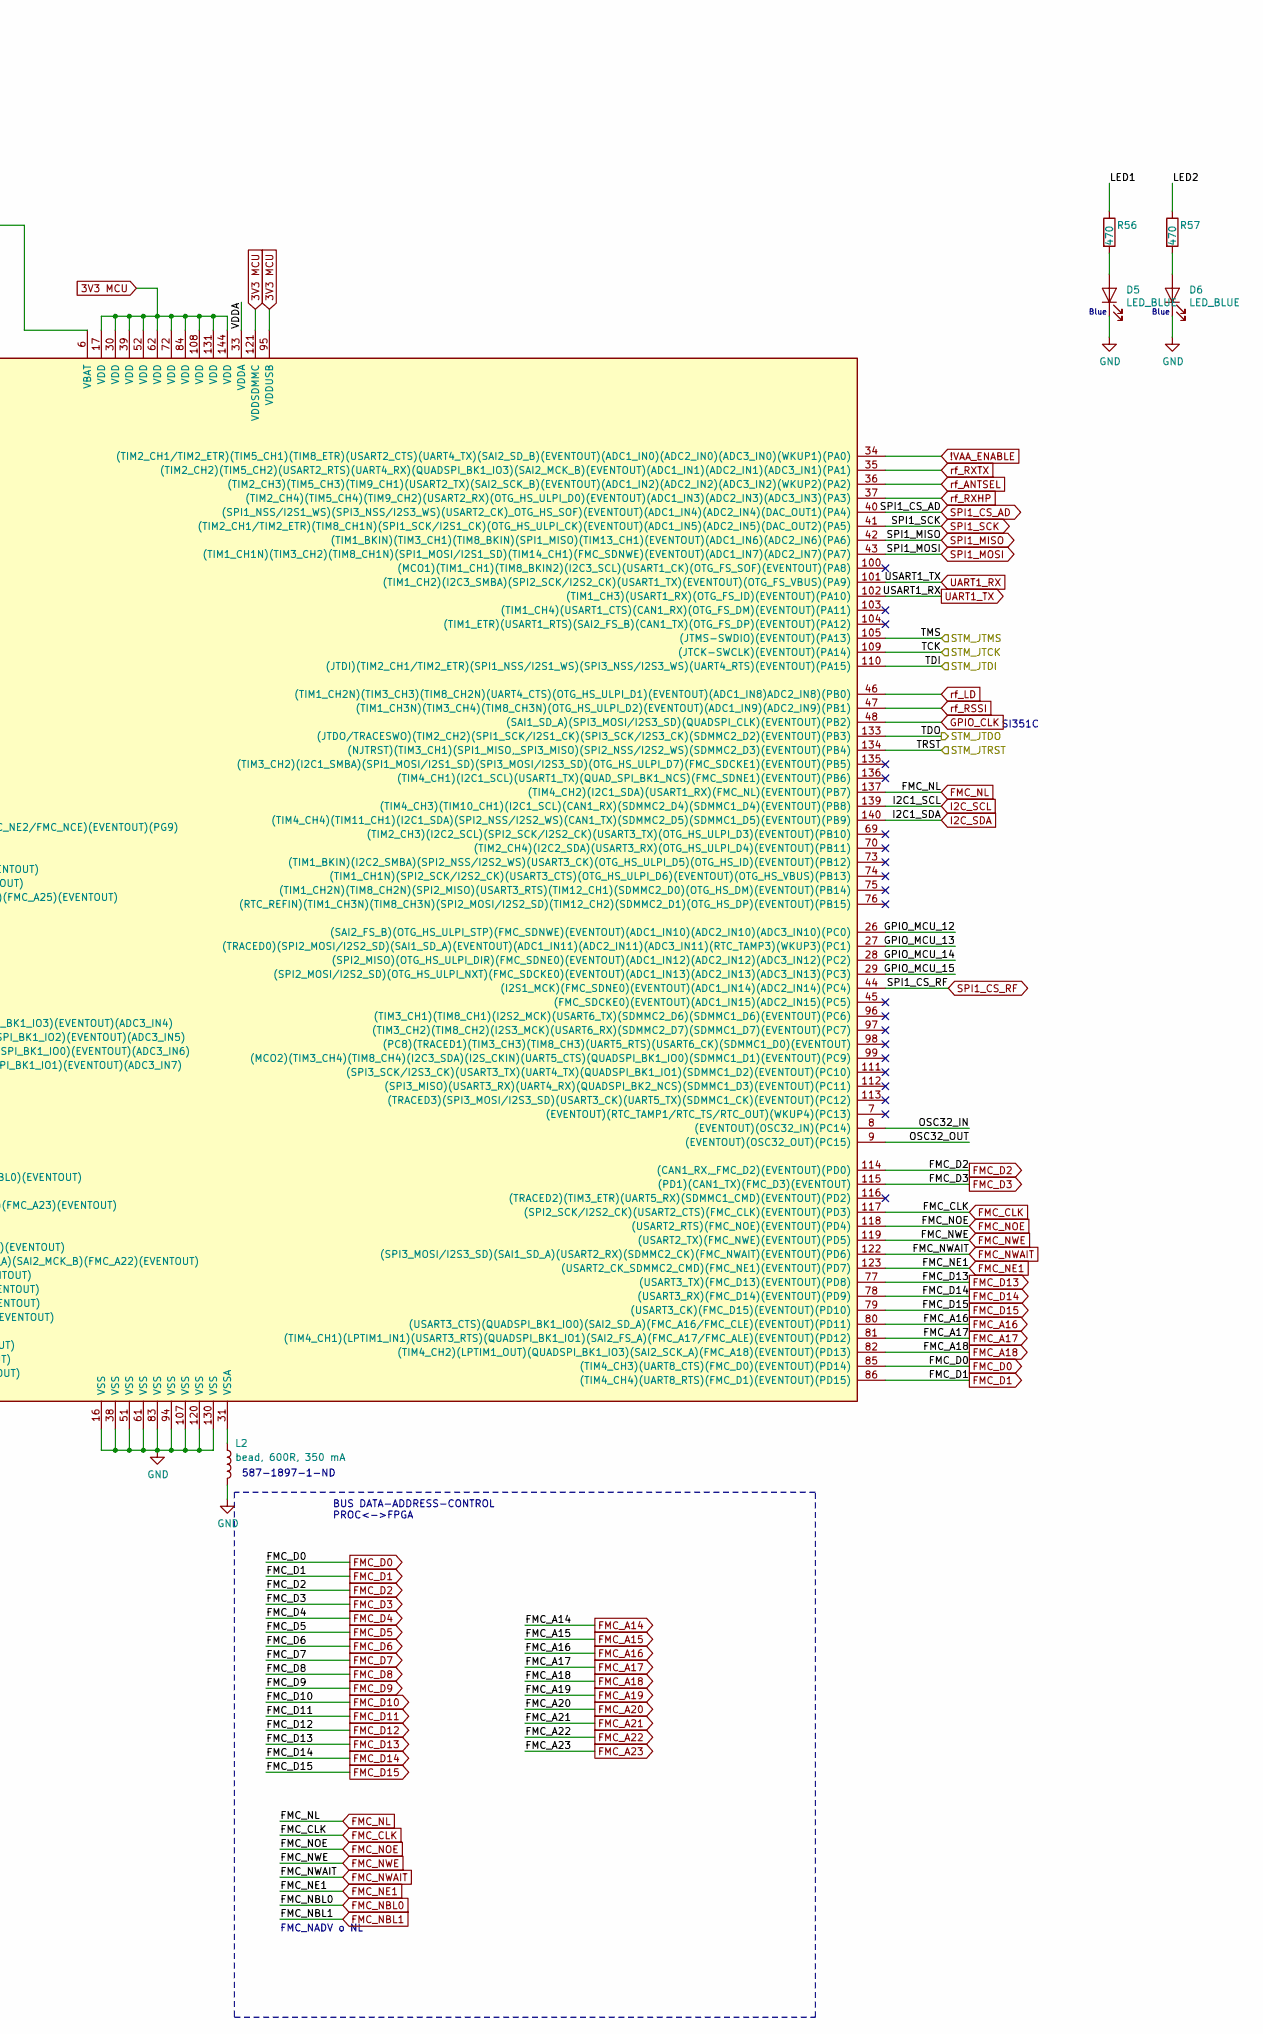
[picture p34: schematic proc.sch, part in row 1, column 2]

Parts:
BT1: Battery_Cell; MPD_BK-870; Digikey BK-870-ND
C87, C88, C89, C93, C95, C96, C97, C98, C99, C102, C105, C106, C107, C108, C112: 100nF; C_0603_1608Metric_Pad1.05x0.95mm_HandSolder; Digikey 1276-1000-1-ND
C90, C94, C103, C104: 1uF; C_0603_1608Metric_Pad1.05x0.95mm_HandSolder; Digikey 1276-1182-1-ND
C91, C100: 6pF; C_0603_1608Metric_Pad1.05x0.95mm_HandSolder; Digikey 1276-2133-1-ND
C92, C101: 10pF; C_0603_1608Metric_Pad1.05x0.95mm_HandSolder; Digikey 1276-1027-1-ND
C109: 4.7uF; C_0603_1608Metric_Pad1.05x0.95mm_HandSolder; Digikey 1276-1045-1-ND
C110, C111: 2.2uF; C_0603_1608Metric_Pad1.05x0.95mm_HandSolder; Digikey 1276-1085-1-ND
D5, D6: LED_BLUE; LED_0805_2012Metric_Pad1.15x1.40mm_HandSolder; Digikey 160-2032-1-ND
J3: Conn_02x10_Top_Bottom; PinHeader_2x10_P2.54mm_Vertical; Digikey 609-3221-ND
J7: Conn_01x03_Male; PinHeader_1x03_P2.54mm_Vertical; Digikey 732-5316-ND
L1, L2: bead, 600R, 350 mA; L_0603_1608Metric_Pad1.05x0.95mm_HandSolder; Digikey 587-1897-1-ND
R54: 10k; R_0603_1608Metric_Pad1.05x0.95mm_HandSolder; Digikey 311-10KGRCT-ND
R55: 1k; R_0603_1608Metric_Pad1.05x0.95mm_HandSolder; Digikey 311-1.00KHRCT-ND
R56, R57: 470; R_0603_1608Metric_Pad1.05x0.95mm_HandSolder; Digikey 311-470GRCT-ND
S4: TL1014BF160QG; Digikey EG5042CT-ND
U5: STM32F722ZET; LQFP-144_20x20mm_P0.5mm; Digikey 497-18558-ND
X3: CRYSTAL; NX3215SA; Digikey 644-1171-1-ND
X4: GSG-XTAL4PIN-16MHz; GSG-XTAL3.2x2.5mm; Digikey 535-10289-1-ND

Connections:
3V3 MCU: C87.1, C88.1, C90.1, C93.1, C95.1, C96.1, C97.1, C98.1, C102.1, C103.1, C104.1, C105.1, C106.1, C107.1, C108.1, C109.1, J3.1, J3.2, J7.1, L1.1, R54.1, U5.17 (VDD), U5.30 (VDD), U5.32 (VREF+), U5.39 (VDD), U5.52 (VDD), U5.62 (VDD), U5.72 (VDD), U5.84 (VDD), U5.95 (VDDUSB), U5.108 (VDD), U5.121 (VDDSDMMC), U5.131 (VDD), U5.143 (PDR_ON), U5.144 (VDD); also elsewhere on the board
!VAA_ENABLE: U5.34 ((TIM2_CH1/TIM2_ETR)(TIM5_CH1)(TIM8_ETR)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); also elsewhere on the board
/BOOT_0: R55.1, U5.138 (BOOT0); also elsewhere on the board
/OMG_JNRST: C99.1, R54.2, S4.1, S4.2, U5.25 (NRST); also elsewhere on the board
/OMG_JTCK: U5.109 ((JTCK-SWCLK)(EVENTOUT)(PA14)); also elsewhere on the board
/OMG_JTDI: U5.110 ((JTDI)(TIM2_CH1/TIM2_ETR)(SPI1_NSS/I2S1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); also elsewhere on the board
/OMG_JTMS: U5.105 ((JTMS-SWDIO)(EVENTOUT)(PA13)); also elsewhere on the board
/OMG_JTRST: U5.134 ((NJTRST)(TIM3_CH1)(SPI1_MISO,_SPI3_MISO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); also elsewhere on the board
/STM_JTDO: U5.133 ((JTDO/TRACESWO)(TIM2_CH2)(SPI1_SCK/I2S1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); also elsewhere on the board
/proc/GPIO_MCU_1: J3.3, U5.10 ((PF0)(I2C2_SDA)(FMC_A0)(EVENTOUT))
/proc/GPIO_MCU_2: J3.4, U5.11 ((PF1)(I2C2_SCL)(FMC_A1)(EVENTOUT))
/proc/GPIO_MCU_3: J3.5, U5.12 ((PF2)(I2C2_SMBA)(FMC_A2)(EVENTOUT))
/proc/GPIO_MCU_4: J3.6, U5.13 ((PF3)(FMC_A3)(EVENTOUT)(ADC3_IN9))
/proc/GPIO_MCU_5: J3.7, U5.14 ((PF4)(FMC_A4)(EVENTOUT)(ADC3_IN14))
/proc/GPIO_MCU_6: J3.8, U5.15 ((PF5)(FMC_A5)(EVENTOUT)(ADC3_IN15))
/proc/GPIO_MCU_7: J3.9, U5.18 ((PF6)(TIM10_CH1)(SPI5_NSS)(SAI1_SD_B)(U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)
/proc/GPIO_MCU_8: J3.10, U5.19 ((PF7)(TIM11_CH1)(SPI5_SCK)(SAI1_MCLK_B)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)
/proc/GPIO_MCU_9: J3.11, U5.20 ((PF8)(SPI5_MISO)(SAI1_SCK_B)(UART7_RTS)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)
/proc/GPIO_MCU_10: J3.12, U5.21 ((PF9)(SPI5_MOSI)(SAI1_FS_B)(UART7_CTS)(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)
/proc/GPIO_MCU_11: J3.13, U5.22 ((PF10)(EVENTOUT)(ADC3_IN8))
/proc/GPIO_MCU_12: J3.14, U5.26 ((SAI2_FS_B)(OTG_HS_ULPI_STP)(FMC_SDNWE)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)
/proc/GPIO_MCU_13: J3.15, U5.27 ((TRACED0)(SPI2_MOSI/I2S2_SD)(SAI1_SD_A)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)
/proc/GPIO_MCU_14: J3.16, U5.28 ((SPI2_MISO)(OTG_HS_ULPI_DIR)(FMC_SDNE0)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)
/proc/GPIO_MCU_15: J3.17, U5.29 ((SPI2_MOSI/I2S2_SD)(OTG_HS_ULPI_NXT)(FM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)
/proc/LED1: R56.1, U5.56 ((PG0)(FMC_A10)(EVENTOUT))
/proc/LED2: R57.1, U5.57 ((PG1)(FMC_A11)(EVENTOUT))
/proc/OSC32_IN: C91.1, U5.8 ((EVENTOUT)(OSC32_IN)(PC14)), X3.1
/proc/OSC32_OUT: C100.1, U5.9 ((EVENTOUT)(OSC32_OUT)(PC15)), X3.2
/proc/OSC_IN: C92.1, U5.23 ((PH0)(EVENTOUT)(OSC_IN)), X4.1
/proc/OSC_OUT: C101.1, U5.24 ((PH1)(EVENTOUT)(OSC_OUT)), X4.3
/proc/VDDA: C89.1, C94.1, L1.2, U5.33 (VDDA)
FMC_A14: U5.89 ((PG4)(FMC_A14/FMC_BA0)(EVENTOUT)); also elsewhere on the board
FMC_A15: U5.90 ((PG5)(FMC_A15/FMC_BA1)(EVENTOUT)); also elsewhere on the board
FMC_A16: U5.80 ((USART3_CTS)(QUADSPI_BK1_IO0)(SAI2_SD_A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); also elsewhere on the board
FMC_A17: U5.81 ((TIM4_CH1)(LPTIM1_IN1)(USART3_RTS)(QUAD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); also elsewhere on the board
FMC_A18: U5.82 ((TIM4_CH2)(LPTIM1_OUT)(QUADSPI_BK1_IO3)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); also elsewhere on the board
FMC_A19: U5.2 ((PE3)(TRACED0)(SAI1_SD_B)(FMC_A19)(EVEN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); also elsewhere on the board
FMC_A20: U5.3 ((PE4)(TRACED1)(SPI4_NSS)(SAI1_FS_A)(FMC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); also elsewhere on the board
FMC_A21: U5.4 ((PE5)(TRACED2)(TIM9_CH1)(SPI4_MISO)(SAI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); also elsewhere on the board
FMC_A22: U5.5 ((PE6)(TRACED3)(TIM1_BKIN2)(TIM9_CH2)(SP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); also elsewhere on the board
FMC_A23: U5.1 ((PE2)(TRACECLK)(SPI4_SCK)(SAI1_MCLK_A)(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); also elsewhere on the board
FMC_CLK: U5.117 ((SPI2_SCK/I2S2_CK)(USART2_CTS)(FMC_CLK)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); also elsewhere on the board
FMC_D0: U5.85 ((TIM4_CH3)(UART8_CTS)(FMC_D0)(EVENTOUT)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); also elsewhere on the board
FMC_D1: U5.86 ((TIM4_CH4)(UART8_RTS)(FMC_D1)(EVENTOUT)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); also elsewhere on the board
FMC_D2: U5.114 ((CAN1_RX,_FMC_D2)(EVENTOUT)(PD0)); also elsewhere on the board
FMC_D3: U5.115 ((PD1)(CAN1_TX)(FMC_D3)(EVENTOUT)); also elsewhere on the board
FMC_D4: U5.58 ((PE7)(TIM1_ETR)(UART7_Rx)(QUADSPI_BK2_I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); also elsewhere on the board
FMC_D5: U5.59 ((PE8)(TIM1_CH1N)(UART7_Tx)(QUADSPI_BK2_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); also elsewhere on the board
FMC_D6: U5.60 ((PE9)(TIM1_CH1)(UART7_RTS)(QUADSPI_BK2_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); also elsewhere on the board
FMC_D7: U5.63 ((PE10)(TIM1_CH2N)(UART7_CTS)(QUADSPI_BK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); also elsewhere on the board
FMC_D8: U5.64 ((PE11)(TIM1_CH2)(SPI4_NSS)(SAI2_SD_B)(F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); also elsewhere on the board
FMC_D9: U5.65 ((PE12)(TIM1_CH3N)(SPI4_SCK)(SAI2_SCK_B)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); also elsewhere on the board
FMC_D10: U5.66 ((PE13)(TIM1_CH3)(SPI4_MISO)(SAI2_FS_B)(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); also elsewhere on the board
FMC_D11: U5.67 ((PE14)(TIM1_CH4)(SPI4_MOSI)(SAI2_MCK_B)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); also elsewhere on the board
FMC_D12: U5.68 ((PE15)(TIM1_BKIN)(FMC_D12)(EVENTOUT)); also elsewhere on the board
FMC_D13: U5.77 ((USART3_TX)(FMC_D13)(EVENTOUT)(PD8)); also elsewhere on the board
FMC_D14: U5.78 ((USART3_RX)(FMC_D14)(EVENTOUT)(PD9)); also elsewhere on the board
FMC_D15: U5.79 ((USART3_CK)(FMC_D15)(EVENTOUT)(PD10)); also elsewhere on the board
FMC_NBL0: U5.141 ((PE0)(TIM4_ETR)(LPTIM1_ETR)(UART8_Rx)(S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); also elsewhere on the board
FMC_NBL1: U5.142 ((PE1)(LPTIM1_IN2)(UART8_Tx)(FMC_NBL1)(E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); also elsewhere on the board
FMC_NE1: U5.123 ((USART2_CK_SDMMC2_CMD)(FMC_NE1)(EVENTOU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); also elsewhere on the board
FMC_NL: U5.137 ((TIM4_CH2)(I2C1_SDA)(USART1_RX)(FMC_NL)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); also elsewhere on the board
FMC_NOE: U5.118 ((USART2_RTS)(FMC_NOE)(EVENTOUT)(PD4)); also elsewhere on the board
FMC_NWAIT: U5.122 ((SPI3_MOSI/I2S3_SD)(SAI1_SD_A)(USART2_R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); also elsewhere on the board
FMC_NWE: U5.119 ((USART2_TX)(FMC_NWE)(EVENTOUT)(PD5)); also elsewhere on the board
GND: BT1.2 (-), C87.2, C88.2, C89.2, C90.2, C91.2, C92.2, C93.2, C94.2, C95.2, C96.2, C97.2, C98.2, C99.2, C100.2, C101.2, C102.2, C103.2, C104.2, C105.2, C106.2, C107.2, C108.2, C109.2, C110.1, C111.1, C112.2, D5.1 (K), D6.1 (K), J3.18, J3.19, J3.20, L2.2, R55.2, S4.3, S4.4, U5.16 (VSS), U5.38 (VSS), U5.51 (VSS), U5.61 (VSS), U5.83 (VSS), U5.94 (VSS), U5.107 (VSS), U5.120 (VSS), U5.130 (VSS), X4.2, X4.4; also elsewhere on the board
GPIO_CLK: U5.48 ((SAI1_SD_A)(SPI3_MOSI/I2S3_SD)(QUADSPI_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); also elsewhere on the board
GPIO_INTR: U5.50 ((PF12)(FMC_A6)(EVENTOUT)); also elsewhere on the board
I2C_SCL: U5.139 ((TIM4_CH3)(TIM10_CH1)(I2C1_SCL)(CAN1_RX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); also elsewhere on the board
I2C_SDA: U5.140 ((TIM4_CH4)(TIM11_CH1)(I2C1_SDA)(SPI2_NS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); also elsewhere on the board
MCU_CLK: U5.49 ((PF11)(SPI5_MOSI)(SAI2_SD_B)(FMC_SDNRAS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); also elsewhere on the board
unnamed: BT1.1 (+), J7.3
unnamed: C110.2, U5.71 (VCAP_1)
unnamed: C111.2, U5.106 (VCAP_2)
unnamed: C112.1, J7.2, U5.6 (VBAT)
unnamed: D5.2 (A), R56.2
unnamed: D6.2 (A), R57.2
unnamed: L2.1, U5.31 (VSSA)
SPI1_CS_AD: U5.40 ((SPI1_NSS/I2S1_WS)(SPI3_NSS/I2S3_WS)(US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); also elsewhere on the board
SPI1_CS_RF: U5.44 ((I2S1_MCK)(FMC_SDNE0)(EVENTOUT)(ADC1_IN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); also elsewhere on the board
SPI1_MISO: U5.42 ((TIM1_BKIN)(TIM3_CH1)(TIM8_BKIN)(SPI1_M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); also elsewhere on the board
SPI1_MOSI: U5.43 ((TIM1_CH1N)(TIM3_CH2)(TIM8_CH1N)(SPI1_M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); also elsewhere on the board
SPI1_SCK: U5.41 ((TIM2_CH1/TIM2_ETR)(TIM8_CH1N)(SPI1_SCK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); also elsewhere on the board
UART1_RX: U5.101 ((TIM1_CH2)(I2C3_SMBA)(SPI2_SCK/I2S2_CK)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); also elsewhere on the board
UART1_TX: U5.102 ((TIM1_CH3)(USART1_RX)(OTG_FS_ID)(EVENTO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); also elsewhere on the board
rf_!SHDN: U5.53 ((PF13)(FMC_A7)(EVENTOUT)); also elsewhere on the board
rf_ANTSEL: U5.36 ((TIM2_CH3)(TIM5_CH3)(TIM9_CH1)(USART2_T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); also elsewhere on the board
rf_LD: U5.46 ((TIM1_CH2N)(TIM3_CH3)(TIM8_CH2N)(UART4_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); also elsewhere on the board
rf_RSSI: U5.47 ((TIM1_CH3N)(TIM3_CH4)(TIM8_CH3N)(OTG_HS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); also elsewhere on the board
rf_RXHP: U5.37 ((TIM2_CH4)(TIM5_CH4)(TIM9_CH2)(USART2_R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); also elsewhere on the board
rf_RXTX: U5.35 ((TIM2_CH2)(TIM5_CH2)(USART2_RTS)(UART4_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); also elsewhere on the board

Notes on the sheet:
PARA LOS PINES DE ALIMENTACION VDD {slash} VSS
PARA VDDA{slash}VSSA
pagina 100 y 157
para VREF+
para VDDSDMMC
pagina 100
para VDDUSB REVISAR
C_L=(CL1*CL2){slash}(CL1+CL2)+CS C_L:capacitancia cristal Cs:capacitancia cto entre 5 pf y 10pf CL1=CL2 typ (5pF-25pF)
ALTA FRECUENCIA
BAJA FRECUENCIA
recordar resistencia R_EXT
R_EXT=1{slash}(2*PI*frec*CL2)
RTC Battery
BUS DATA-ADDRESS-CONTROL PROC<->FPGA
587-1897-1-ND
Blue
SI351C
FMC_NADV o NL

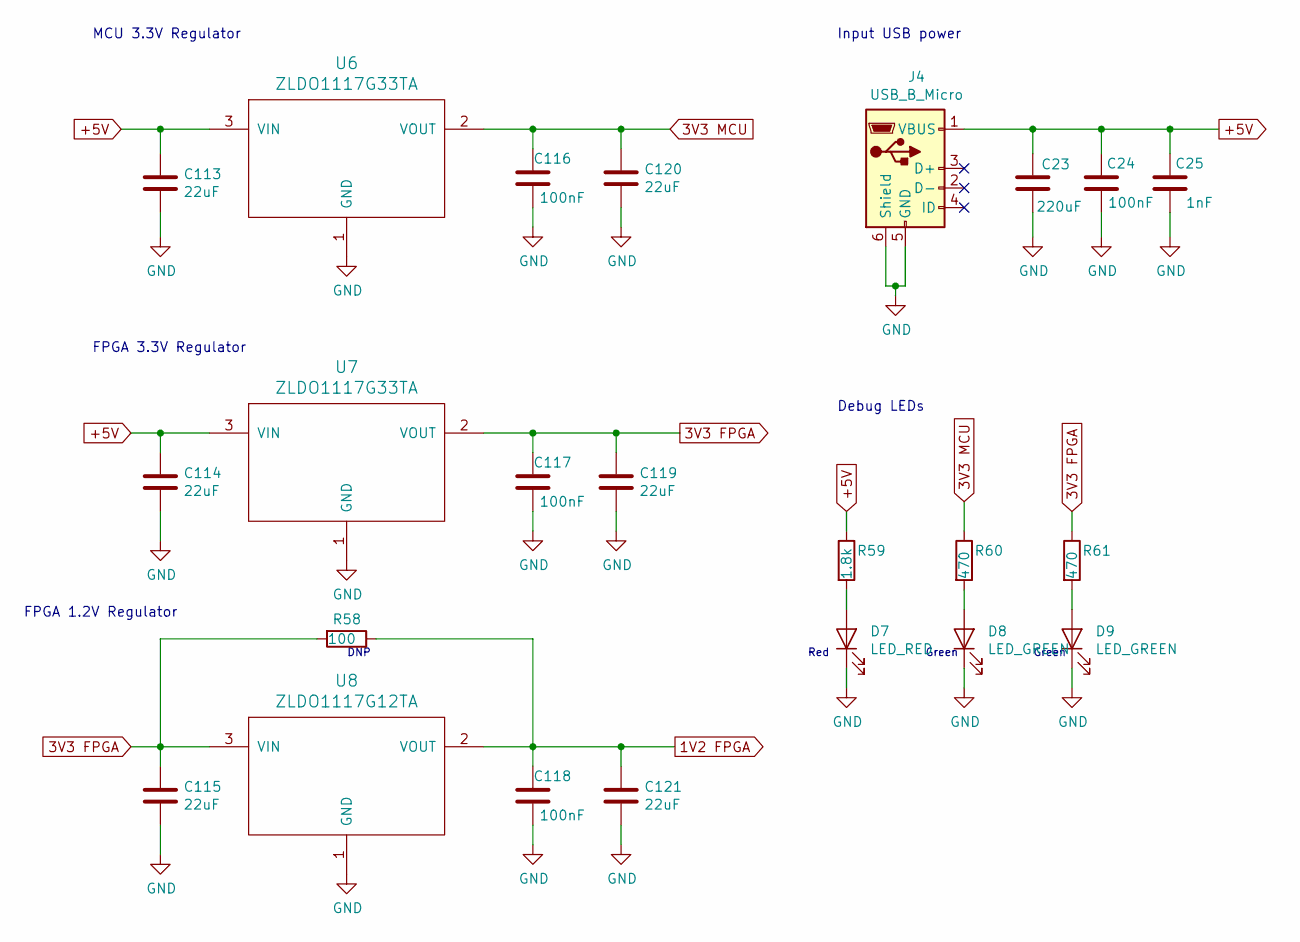
[picture p35: schematic power.sch]

Parts:
C23: 220uF; R_1210_3225Metric_Pad1.42x2.65mm_HandSolder; Digikey 1276-3375-1-ND
C24, C116, C117, C118: 100nF; C_0603_1608Metric_Pad1.05x0.95mm_HandSolder; Digikey 1276-1000-1-ND
C25: 1nF; C_0603_1608Metric_Pad1.05x0.95mm_HandSolder; Digikey 1276-1018-1-ND
C113, C114, C115, C119, C120, C121: 22uF; R_0603_1608Metric_Pad1.05x0.95mm_HandSolder; Digikey 1276-6504-1-ND
D7: LED_RED; LED_0805_2012Metric_Pad1.15x1.40mm_HandSolder; Digikey 160-1469-1-ND
D8, D9: LED_GREEN; LED_0805_2012Metric_Pad1.15x1.40mm_HandSolder; Digikey 160-1468-1-ND
J4: USB_B_Micro; USB_Micro_B_Female_10118194-0001LF; Digikey 609-4618-1-ND
R58: 100; R_0603_1608Metric_Pad1.05x0.95mm_HandSolder; Digikey 311-100HRCT-ND
R59: 1.8k; R_0603_1608Metric_Pad1.05x0.95mm_HandSolder; Digikey 311-1.8KGRTR-ND
R60, R61: 470; R_0603_1608Metric_Pad1.05x0.95mm_HandSolder; Digikey 311-470GRCT-ND
U6, U7: ZLDO1117G33TA; SOT-223-3_TabPin2; Digikey ZLDO1117G33DICT-ND
U8: ZLDO1117G12TA; SOT-223-3_TabPin2; Digikey ZLDO1117G12DICT-ND

Connections:
1V2 FPGA: C118.1, C121.1, R58.1, U8.2 (VOUT); also elsewhere on the board
3V3 FPGA: C115.1, C117.1, C119.1, R58.2, R61.1, U7.2 (VOUT), U8.3 (VIN); also elsewhere on the board
3V3 MCU: C116.1, C120.1, R60.1, U6.2 (VOUT); also elsewhere on the board
+5V: C23.1, C24.1, C25.1, C113.1, C114.1, J4.1 (VBUS), R59.1, U6.3 (VIN), U7.3 (VIN); also elsewhere on the board
GND: C23.2, C24.2, C25.2, C113.2, C114.2, C115.2, C116.2, C117.2, C118.2, C119.2, C120.2, C121.2, D7.1 (K), D8.1 (K), D9.1 (K), J4.5 (GND), J4.6 (Shield), U6.1 (GND), U7.1 (GND), U8.1 (GND); also elsewhere on the board
unnamed: D7.2 (A), R59.2
unnamed: D8.2 (A), R60.2
unnamed: D9.2 (A), R61.2

Notes on the sheet:
MCU 3.3V Regulator
FPGA 3.3V Regulator
FPGA 1.2V Regulator
Input USB power
Debug LEDs
Red
Green
DNP

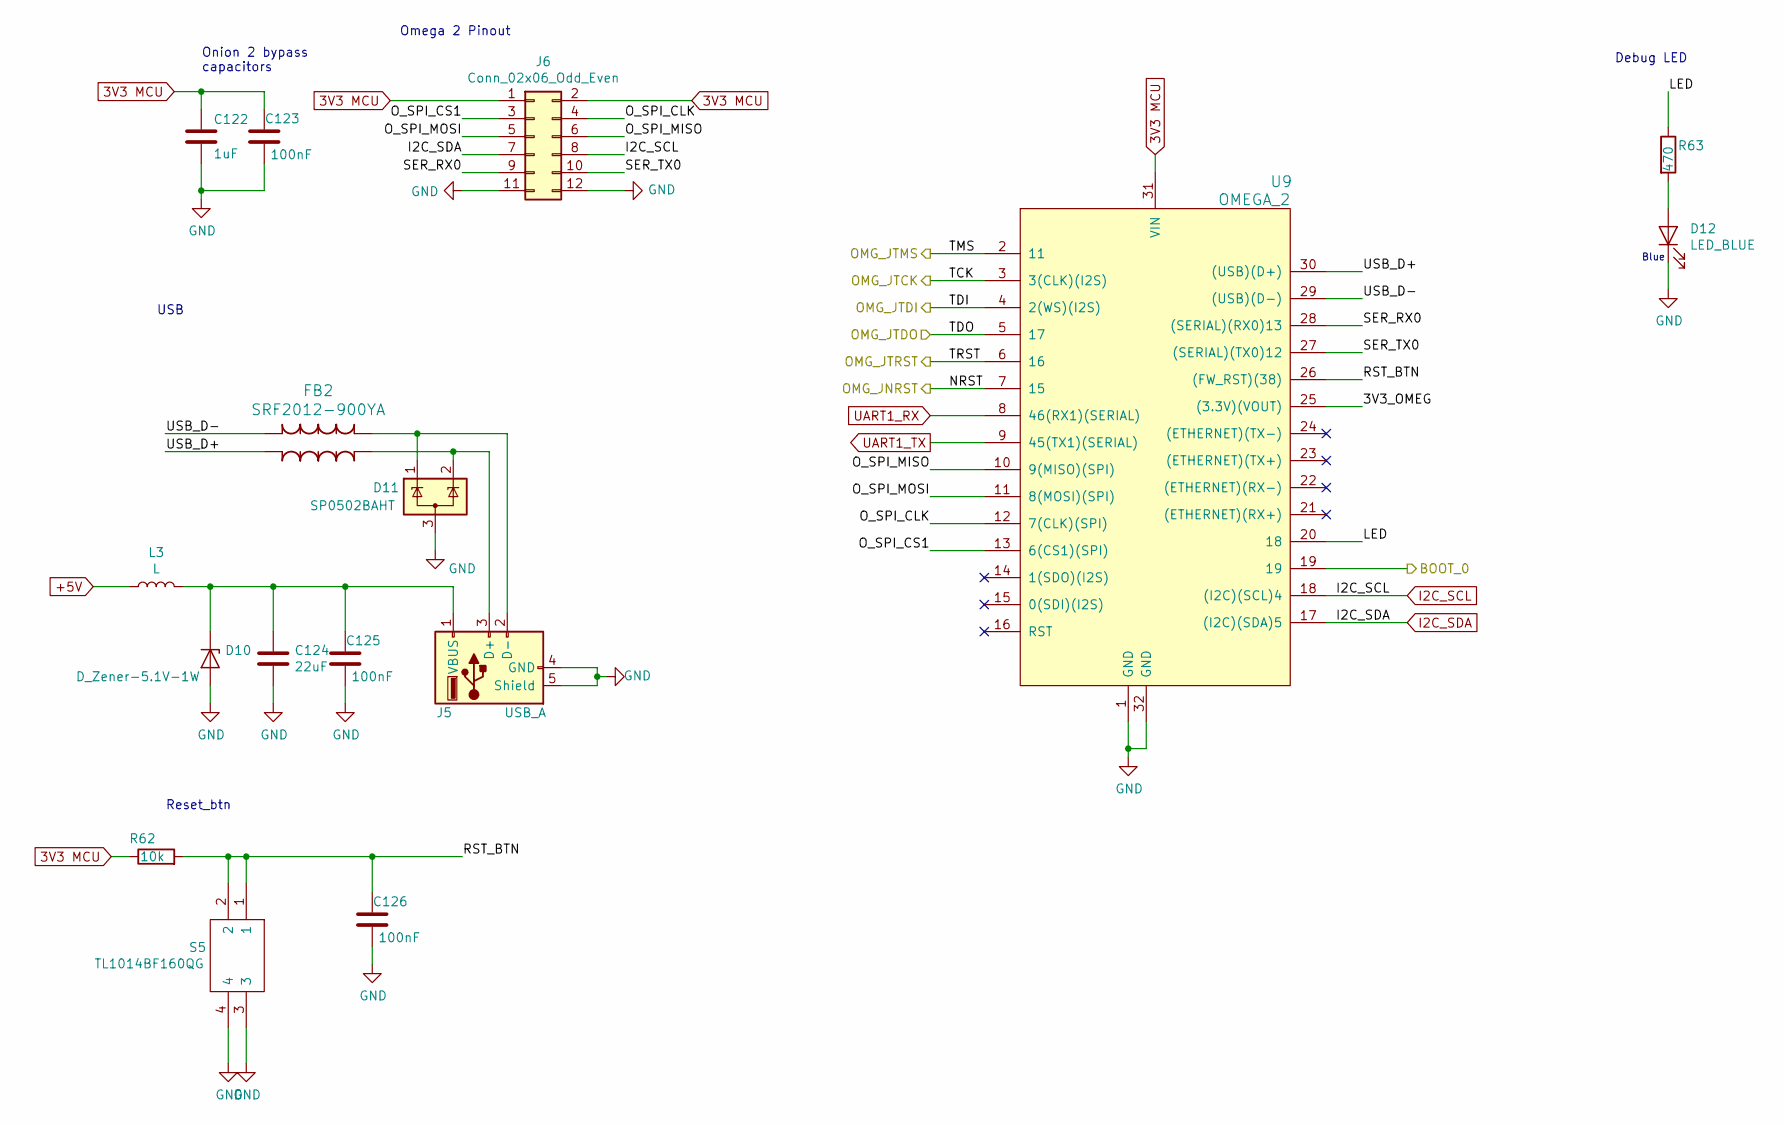
[picture p36: schematic omega_2.sch]

Parts:
C122: 1uF; C_0603_1608Metric_Pad1.05x0.95mm_HandSolder; Digikey 1276-1182-1-ND
C123, C125, C126: 100nF; C_0603_1608Metric_Pad1.05x0.95mm_HandSolder; Digikey 1276-1000-1-ND
C124: 22uF; R_0603_1608Metric_Pad1.05x0.95mm_HandSolder; Digikey 1276-6504-1-ND
D10: D_Zener-5.1V-1W; D_SOD-123; Digikey MMSZ5231BT1GOSCT-ND
D11: SP0502BAHT; SOT-23_Handsoldering; Digikey F2714CT-ND
D12: LED_BLUE; LED_0805_2012Metric_Pad1.15x1.40mm_HandSolder; Digikey 160-2032-1-ND
FB2: SRF2012-900YA; Digikey SRF2012-900YACT-ND
J5: USB_A; USB_A_Female_UE27AC54100; Digikey UE27AC54100-ND
J6: Conn_02x06_Odd_Even; PinHeader_2x06_P2.54mm_Vertical; Digikey 609-3219-ND
L3: L; L_0603_1608Metric_Pad1.05x0.95mm_HandSolder; Digikey 732-1593-1-ND
R62: 10k; R_0603_1608Metric_Pad1.05x0.95mm_HandSolder; Digikey 311-10KGRCT-ND
R63: 470; R_0603_1608Metric_Pad1.05x0.95mm_HandSolder; Digikey 311-470GRCT-ND
S5: TL1014BF160QG; Digikey EG5042CT-ND
U9: OMEGA_2; OMEGA2_PADS; Digikey 2070-OM-O2-ND

Connections:
3V3 MCU: C122.1, C123.1, J6.1, J6.2, R62.1, U9.31 (VIN); also elsewhere on the board
+5V: L3.1; also elsewhere on the board
/BOOT_0: U9.19; also elsewhere on the board
/FPGA_JTDO: U9.5 (17); also elsewhere on the board
/OMG_JNRST: U9.7 (15); also elsewhere on the board
/OMG_JTCK: U9.3 (3(CLK)(I2S)); also elsewhere on the board
/OMG_JTDI: U9.4 (2(WS)(I2S)); also elsewhere on the board
/OMG_JTMS: U9.2 (11); also elsewhere on the board
/OMG_JTRST: U9.6 (16); also elsewhere on the board
/omega_2/3V3_OMEG: U9.25 ((3.3V)(VOUT))
/omega_2/LED: R63.1, U9.20 (18)
/omega_2/O_SPI_CLK: J6.4, U9.12 (7(CLK)(SPI))
/omega_2/O_SPI_CS1: J6.3, U9.13 (6(CS1)(SPI))
/omega_2/O_SPI_MISO: J6.6, U9.10 (9(MISO)(SPI))
/omega_2/O_SPI_MOSI: J6.5, U9.11 (8(MOSI)(SPI))
/omega_2/RST_BTN: C126.1, R62.2, S5.1, S5.2, U9.26 ((FW_RST)(38))
/omega_2/SER_RX0: J6.9, U9.28 ((SERIAL)(RX0)13)
/omega_2/SER_TX0: J6.10, U9.27 ((SERIAL)(TX0)12)
/omega_2/USB_D+: FB2.4, U9.30 ((USB)(D+))
/omega_2/USB_D-: FB2.1, U9.29 ((USB)(D-))
GND: C122.2, C123.2, C124.2, C125.2, C126.2, D10.2 (A), D11.3 (A), D12.1 (K), J5.4 (GND), J5.5 (Shield), J6.11, J6.12, S5.3, S5.4, U9.1 (GND), U9.32 (GND); also elsewhere on the board
I2C_SCL: J6.8, U9.18 ((I2C)(SCL)4); also elsewhere on the board
I2C_SDA: J6.7, U9.17 ((I2C)(SDA)5); also elsewhere on the board
unnamed: C124.1, C125.1, D10.1 (K), J5.1 (VBUS), L3.2
unnamed: D11.1 (K), FB2.2, J5.2 (D-)
unnamed: D11.2 (K), FB2.3, J5.3 (D+)
unnamed: D12.2 (A), R63.2
UART1_RX: U9.8 (46(RX1)(SERIAL)); also elsewhere on the board
UART1_TX: U9.9 (45(TX1)(SERIAL)); also elsewhere on the board

Notes on the sheet:
Onion 2 bypass capacitors
USB
Omega 2 Pinout
Reset_btn
Debug LED
Blue

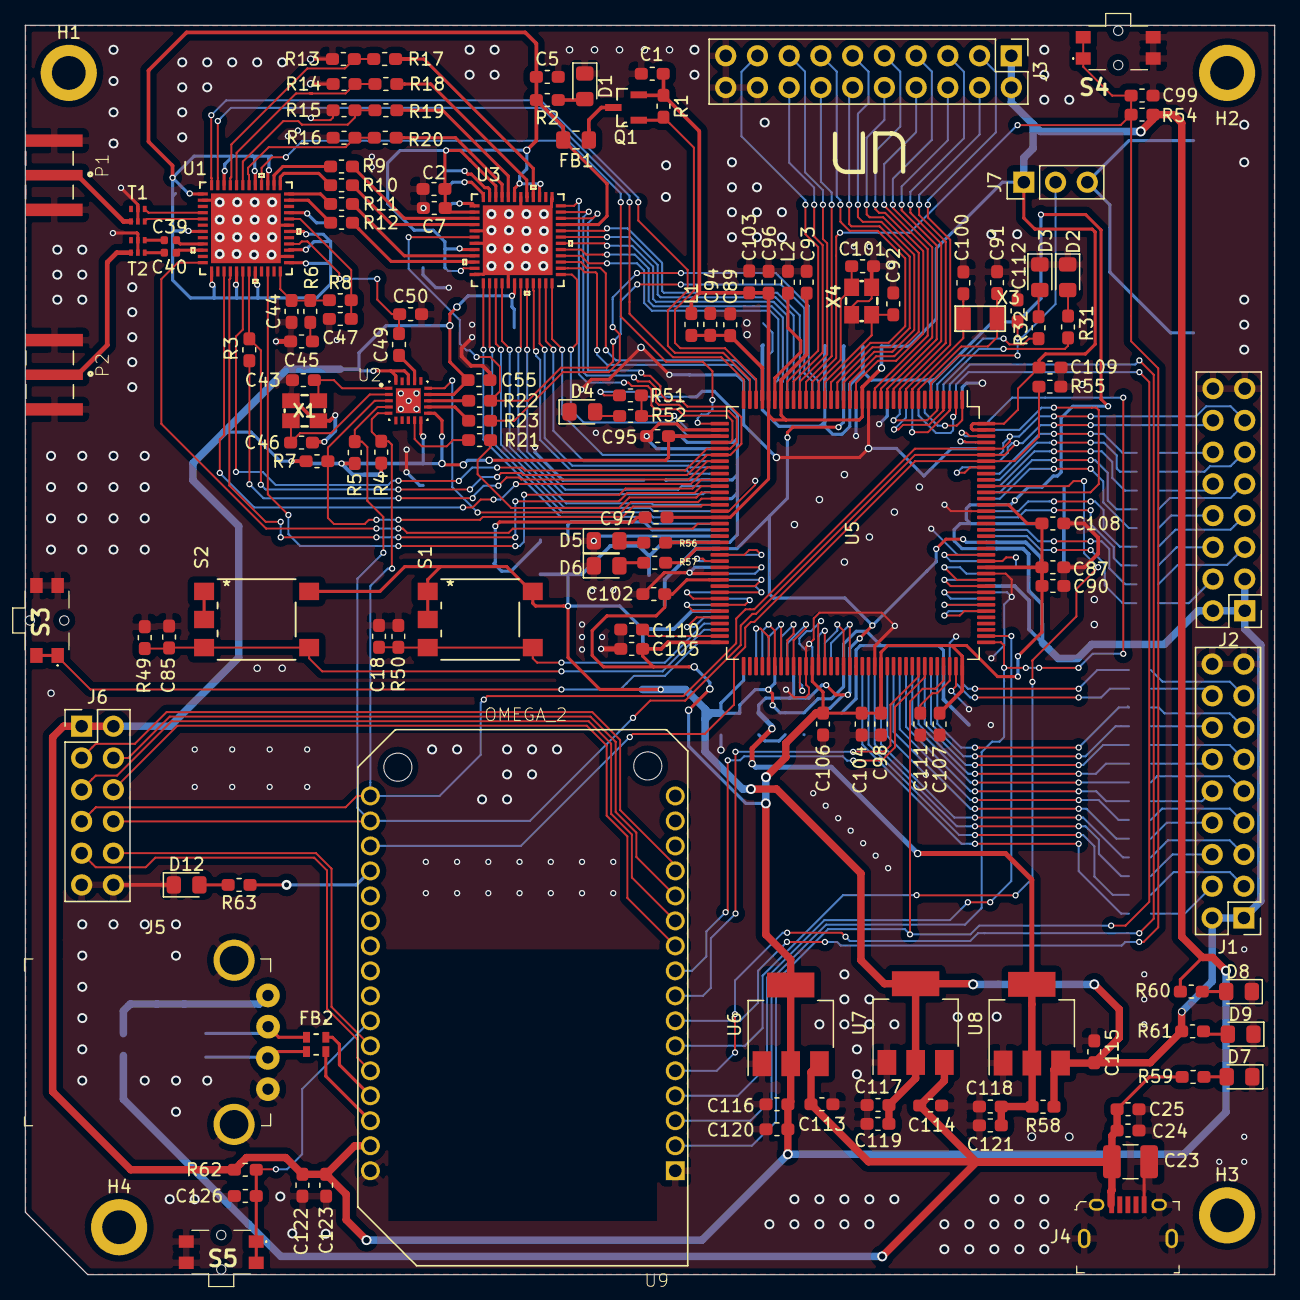
[picture p37: board shield_SDR_UN.kicad_pcb from above]

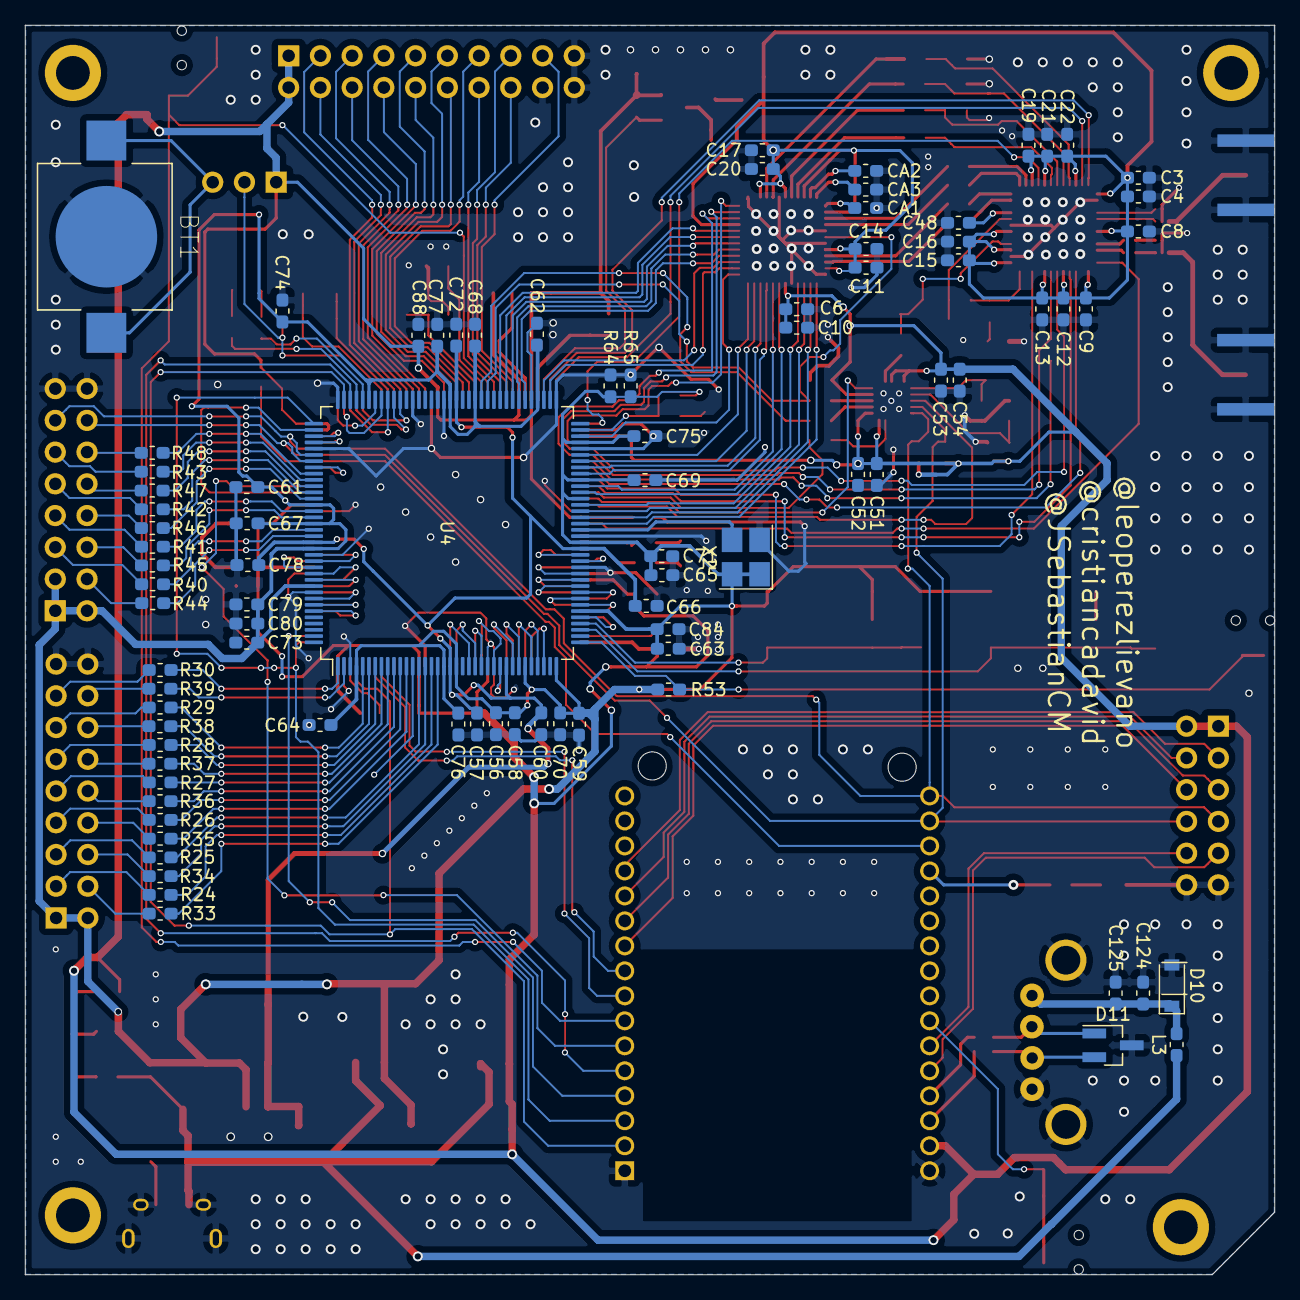
[picture p38: board shield_SDR_UN.kicad_pcb from below]

Board: 2 copper layers, 100.0 x 100.0 mm, 227 parts (86 on the bottom side), 230 nets.
