leoperezlievano/SDR_UN/(commit log)

2019-04-24 First commit - Repository created
    [shield_SDR_UN.kicad_pcb, shield_SDR_UN.sch]
2019-04-29 Subsystems sheets created
    [FPGA.sch, power.sch, proc.sch, rf_front_end.sch, shield_SDR_UN.sch]
2019-05-02 ADC schematic done.
    [rf_front_end.sch]
2019-05-04 proc schematic done test.
    [proc.sch, rf_front_end.sch]
2019-05-07 adicion potencia usb y osc procesador
    [power.sch, proc.sch]
2019-05-07 MAX2830 Symbol/Footprint created
    [power.sch, proc.sch, rf_front_end.sch]
2019-05-09 Onion 2 routed
    [FPGA.sch, omega_2.sch, power.sch, proc.sch, rf_front_end.sch, shield_SDR_UN.sch]
2019-05-13 Se añade el esquema de la FPGA
    [FPGA.sch]
2019-05-14 FPGA-ADC connection
    [FPGA.sch]
2019-05-14 STM32 connection updated
    [FPGA.sch, omega_2.sch, proc.sch]
2019-05-14 Voltage regulators updated
    [power.sch, proc.sch]
2019-05-16 data bus proc-fpga
    [FPGA.sch, proc.sch, shield_SDR_UN.sch]
2019-05-16 Footprint of voltaje regulators edited
    [power.sch]
2019-05-20 bus-v2 proc-fpga
    [FPGA.sch, proc.sch]
2019-05-20 algunos footprint
    [FPGA.sch, omega_2.sch, power.sch, proc.sch, rf_front_end.sch]
2019-05-20 algunos footprint_v2
    [FPGA.sch, omega_2.sch, power.sch, proc.sch, shield_SDR_UN.sch]
2019-05-21 RF-Frontend balun
    [FPGA.sch, power.sch, proc.sch, rf_front_end.sch]
2019-05-22 se agrego el chip multirelojes
    [omega_2.sch, proc.sch, rf_front_end.sch, shield_SDR_UN.sch]
2019-05-22 Footprints added for C and R
    [omega_2.sch, power.sch, proc.sch, rf_front_end.sch]
2019-05-22 Footprints updated
    [FPGA.sch, omega_2.sch, power.sch, proc.sch, rf_front_end.sch]
2019-05-23 OTRA VES FOOTPRINT
    [FPGA.sch, proc.sch, rf_front_end.sch]
2019-05-23 OTRA VES FOOTPRINT_v1
    [FPGA.sch, proc.sch, rf_front_end.sch]
2019-05-23 RF-Front-end connections
    [FPGA.sch, omega_2.sch, power.sch, proc.sch, rf_front_end.sch]
2019-05-23 OTRA VES FOOTPRINT_v2
    [rf_front_end.sch]
2019-05-24 JTAG routed
    [FPGA.sch, omega_2.sch, power.sch, proc.sch, rf_front_end.sch, shield_SDR_UN.sch]
2019-05-25 Schematic finished
    [FPGA.sch, omega_2.sch, power.sch, proc.sch, rf_front_end.sch, shield_SDR_UN.sch]
2019-05-27 organizacion PCB
    [FPGA.sch, omega_2.sch, power.sch, proc.sch, rf_front_end.sch]
2019-05-27 Omega 2 PCB
    [omega_2.sch, proc.sch, rf_front_end.sch, shield_SDR_UN.kicad_pcb]
2019-05-27 organizacion PCB_V2
    [FPGA.sch, shield_SDR_UN.kicad_pcb]
2019-05-27 ADC PCB
    [shield_SDR_UN.kicad_pcb]
2019-05-28 organizacion PCB_V3
    [FPGA.sch, shield_SDR_UN.kicad_pcb]
2019-05-28 Capacitors of RF front-end edited, components placed in the PCB
    [rf_front_end.sch, shield_SDR_UN.kicad_pcb]
2019-05-28 organizacion PCB_V4
    [FPGA.sch, shield_SDR_UN.kicad_pcb]
2019-05-28 PCB :)
    [shield_SDR_UN.kicad_pcb]
2019-05-28 PCB route V1
    [FPGA.sch, omega_2.sch, power.sch, proc.sch, shield_SDR_UN.kicad_pcb]
2019-05-29 PCB route V2
    [power.sch, shield_SDR_UN.kicad_pcb]
2019-05-29 PCB routing
    [shield_SDR_UN.kicad_pcb]
2019-05-29 PCB route V3
    [FPGA.sch, proc.sch, shield_SDR_UN.kicad_pcb]
2019-05-29 PCB, Power stage routed
    [power.sch, proc.sch, shield_SDR_UN.kicad_pcb]
2019-05-30 PCB route V4
    [proc.sch, rf_front_end.sch, shield_SDR_UN.kicad_pcb]
2019-05-30 Switchs modified
    [FPGA.sch, proc.sch, shield_SDR_UN.kicad_pcb]
2019-06-05 Partnumbers modified
    [FPGA.sch, Partes_final.ods, Partes_kicad.ods, Partes_kicad.xlsx, omega_2.sch, power.sch, proc.sch, rf_front_end.sch]
2019-06-05 Partnumbers modified_2
    [Partes_final.xlsx]
2019-06-06 design rules corrections
    [shield_SDR_UN.kicad_pcb]
2019-06-06 Bill of materials updated
    [FPGA.sch, Partes_final.ods, Partes_final.xlsx, omega_2.sch, proc.sch]
2019-06-07 generate gerber files test
    [shield_SDR_UN-B_Cu.gbr, shield_SDR_UN-B_Mask.gbr, shield_SDR_UN-B_SilkS.gbr, shield_SDR_UN-Edge_Cuts.gbr, shield_SDR_UN-F_Cu.gbr, shield_SDR_UN-F_Mask.gbr, shield_SDR_UN-F_SilkS.gbr, shield_SDR_UN-NPTH.drl]
2019-06-07 generate gerber files test_2
    [Partes_final.ods, Partes_final.xlsx, partes_final.ods]
2019-06-07 generate gerber files test_3
    [shield_SDR_UN-B_Cu.gbr, shield_SDR_UN-B_Mask.gbr, shield_SDR_UN-B_SilkS.gbr, shield_SDR_UN-Edge_Cuts.gbr, shield_SDR_UN-F_Cu.gbr, shield_SDR_UN-F_Mask.gbr, shield_SDR_UN-F_SilkS.gbr, shield_SDR_UN-NPTH.drl]
2019-06-09 Gerber files created
    [FPGA.sch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]
2019-07-25 Libraries, Onion Omega files and FPGA blinker added
    [onion.cfg, sysfsgpio-onion.cfg]
2019-07-25 fotos y pdf de la pcb
2019-07-25 STM32F7 Blink added
2019-07-25 Final Software commit
    [onion.cfg]
